CodeCraftsman-Jr/AgroWings/output/detected_sample1.jpg

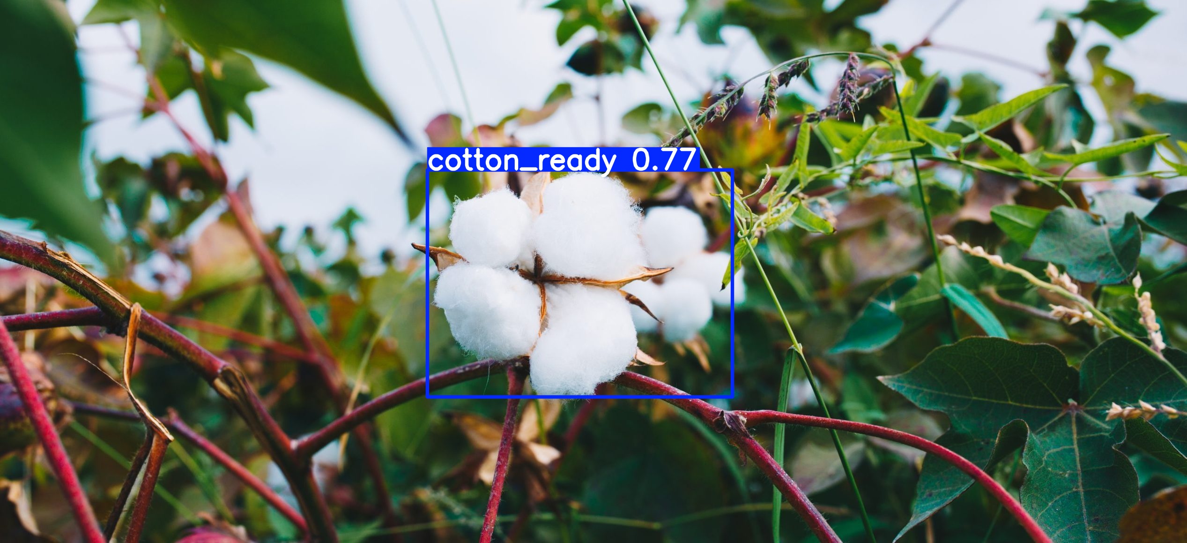
output/detected_sample1.jpg
