CodeCraftsman-Jr/AgroWings/output/detected_sample2.jpeg

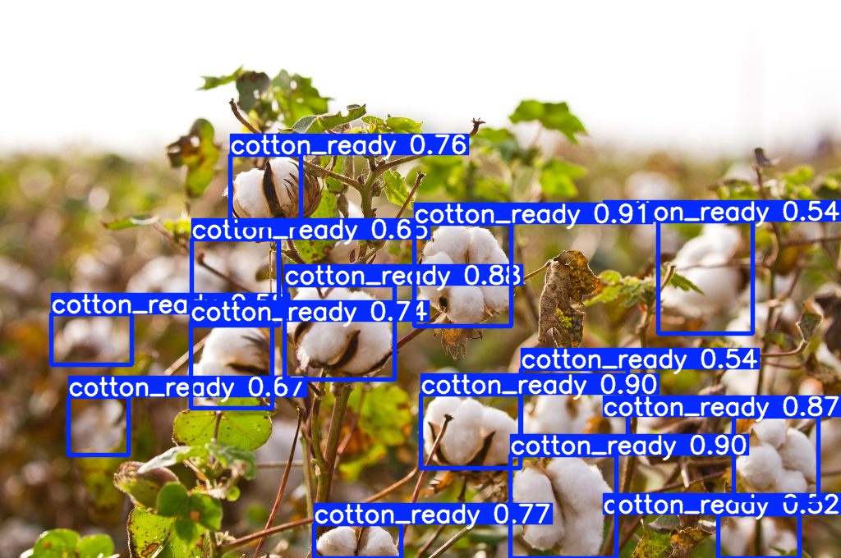
output/detected_sample2.jpeg
