CodeCraftsman-Jr/AgroWings/output/detected_sample3.jpg

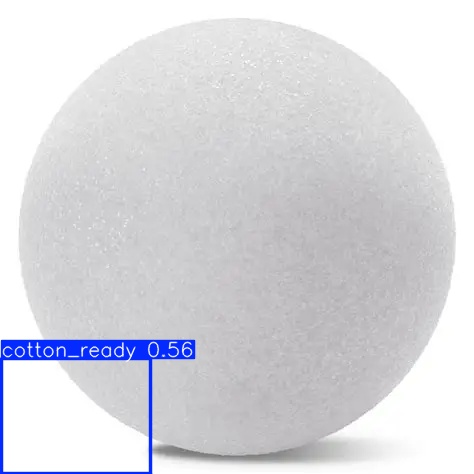
output/detected_sample3.jpg
