CodeCraftsman-Jr/AgroWings/Materials/OpenCR-Hardware-main/OpenCR-Hardware-main/mechanics/LOTR_CTCR/stl_files/Main_Frame.stl

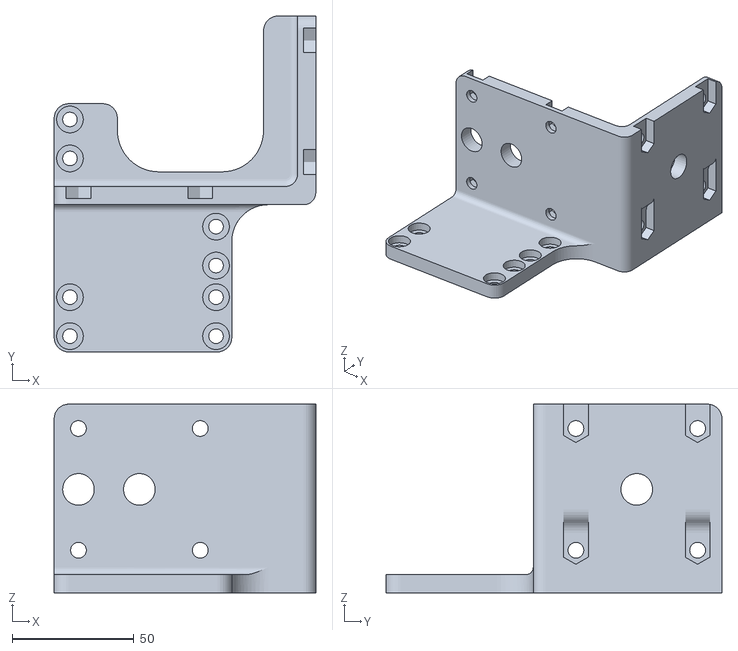
[picture p4: CAD file, 2025-11-28]
Materials/OpenCR-Hardware-main/OpenCR-Hardware-main/mechanics/LOTR_CTCR/stl_files/Main_Frame.stl
107.5 x 138.0 x 77.5
