CodeCraftsman-Jr/AgroWings/Materials/mould/FZ8OJ7DJZ2YTMDP.stl

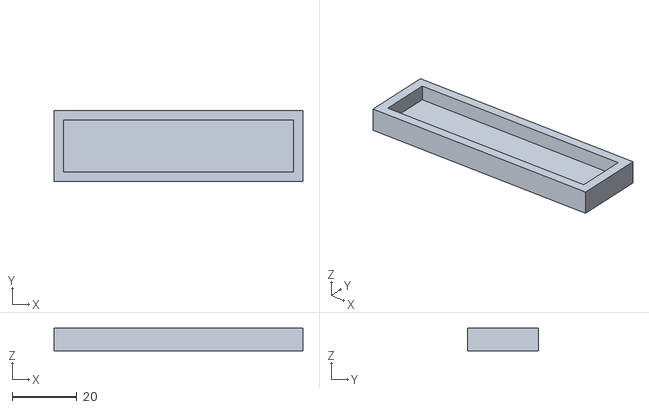
[picture p5: CAD file, 2025-11-28]
Materials/mould/FZ8OJ7DJZ2YTMDP.stl
77.0 x 22.0 x 7.00
