CodeCraftsman-Jr/AgroWings/Materials/OpenCR-Hardware-main/OpenCR-Hardware-main/mechanics/actuation_module/stl_files/ActuationUnit_EncoderCouplingSide.stl

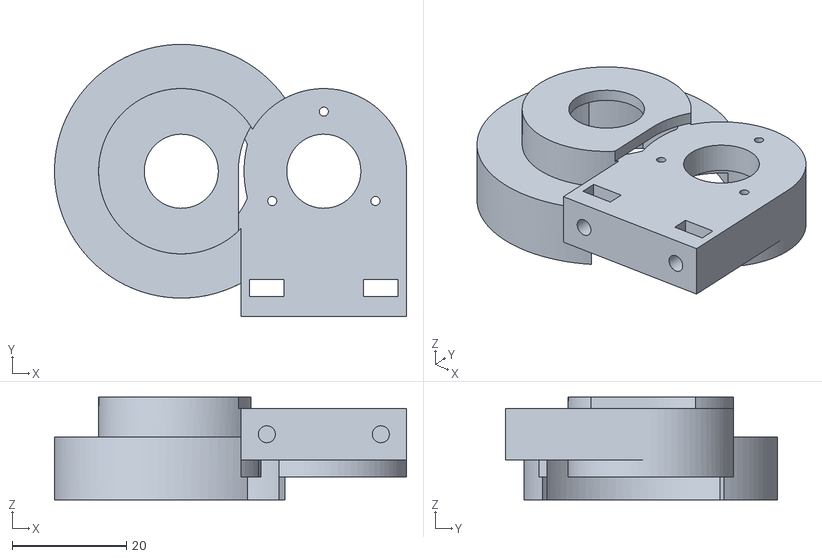
[picture p6: CAD file, 2025-11-28]
Materials/OpenCR-Hardware-main/OpenCR-Hardware-main/mechanics/actuation_module/stl_files/ActuationUnit_EncoderCouplingSide.stl
61.7 x 47.7 x 18.0
