CodeCraftsman-Jr/AgroWings/Materials/OpenCR-Hardware-main/OpenCR-Hardware-main/mechanics/auxiliary_hardware/stl_files/Repeater_vertical.stl

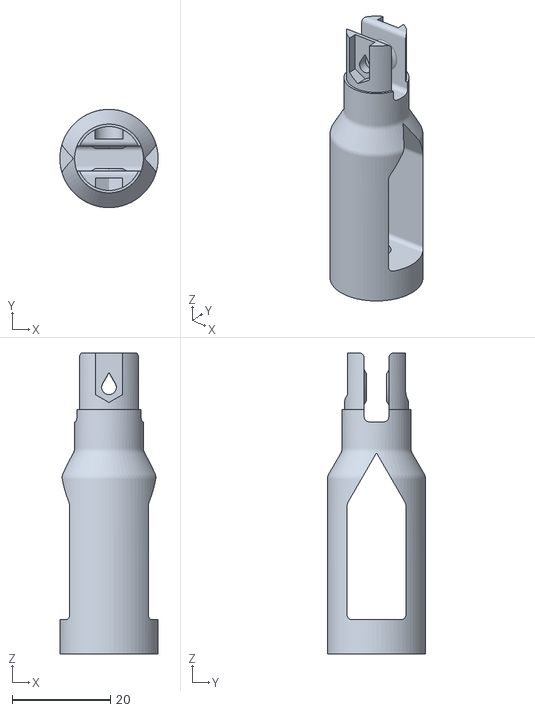
[picture p7: CAD file, 2025-11-28]
Materials/OpenCR-Hardware-main/OpenCR-Hardware-main/mechanics/auxiliary_hardware/stl_files/Repeater_vertical.stl
20.0 x 20.0 x 61.2
