CodeCraftsman-Jr/AgroWings/Materials/OpenCR-Hardware-main/OpenCR-Hardware-main/mechanics/auxiliary_tools/stl_files/FixatorDisk_OD20_13mm_Backbone_ID1.stl

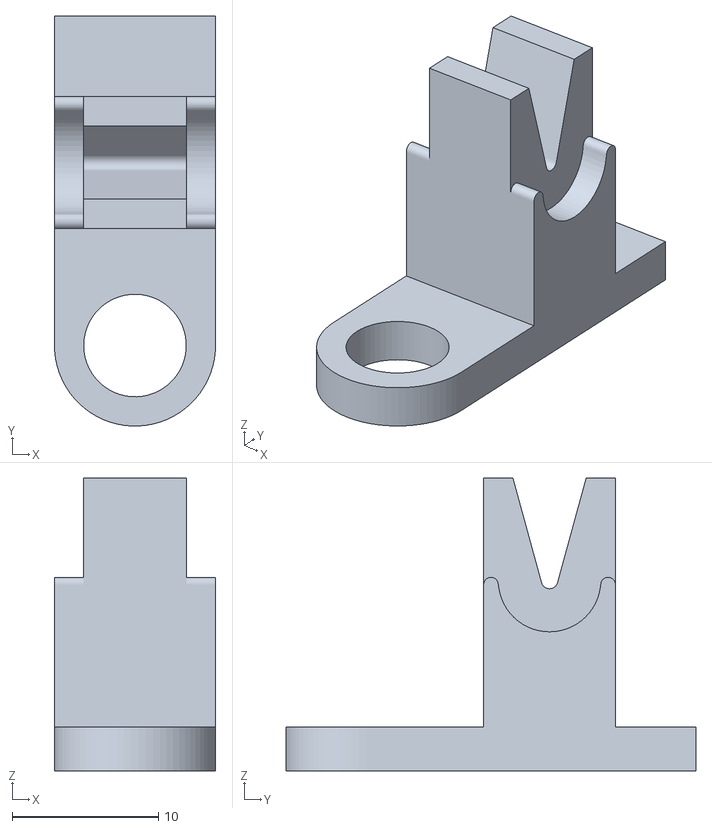
[picture p8: CAD file, 2025-11-28]
Materials/OpenCR-Hardware-main/OpenCR-Hardware-main/mechanics/auxiliary_tools/stl_files/FixatorDisk_OD20_13mm_Backbone_ID1.stl
11.0 x 28.0 x 20.0
