CodeCraftsman-Jr/AgroWings/Materials/OpenCR-Hardware-main/OpenCR-Hardware-main/mechanics/LearningKit_TDCR/stl_files/FSD_Sliced _1.stl

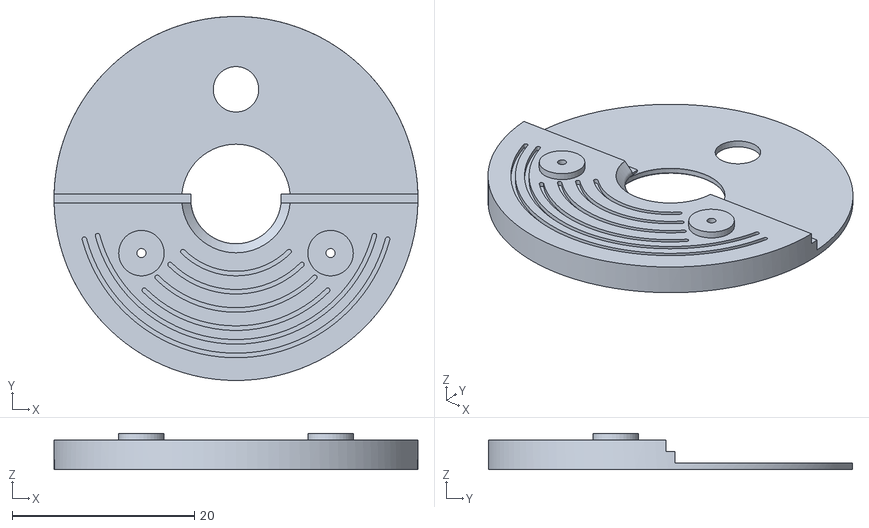
[picture p9: CAD file, 2025-11-28]
Materials/OpenCR-Hardware-main/OpenCR-Hardware-main/mechanics/LearningKit_TDCR/stl_files/FSD_Sliced _1.stl
40.0 x 40.0 x 4.00
