CodeCraftsman-Jr/AgroWings/Materials/OpenCR-Hardware-main/OpenCR-Hardware-main/mechanics/LOTR_CTCR/stl_files/Tube_coppling_0mm49.stl

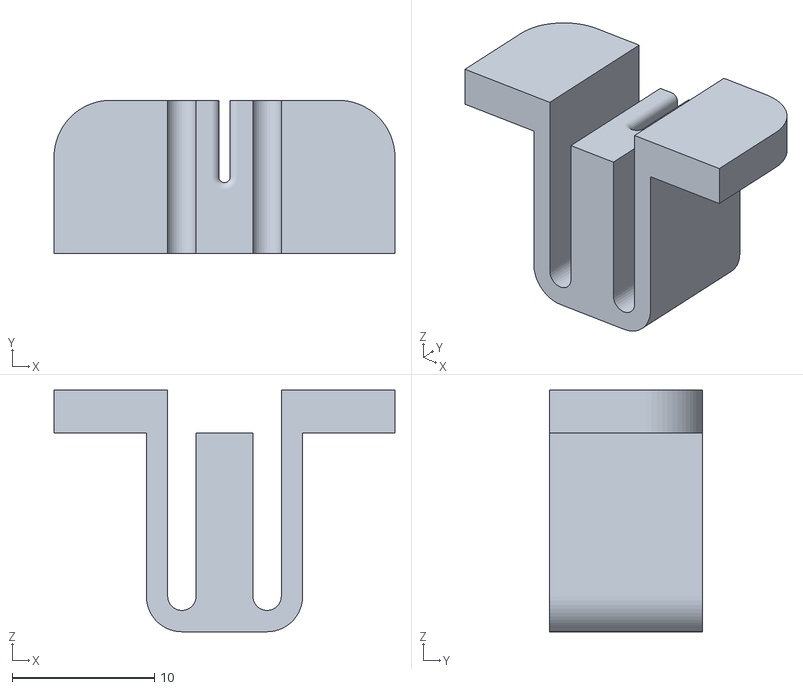
[picture p10: CAD file, 2025-11-28]
Materials/OpenCR-Hardware-main/OpenCR-Hardware-main/mechanics/LOTR_CTCR/stl_files/Tube_coppling_0mm49.stl
24.0 x 10.8 x 17.0
