CodeCraftsman-Jr/AgroWings/Materials/OpenCR-Hardware-main/OpenCR-Hardware-main/mechanics/LOTR_TDCR-planar/stl_files/EE_glider_small.stl

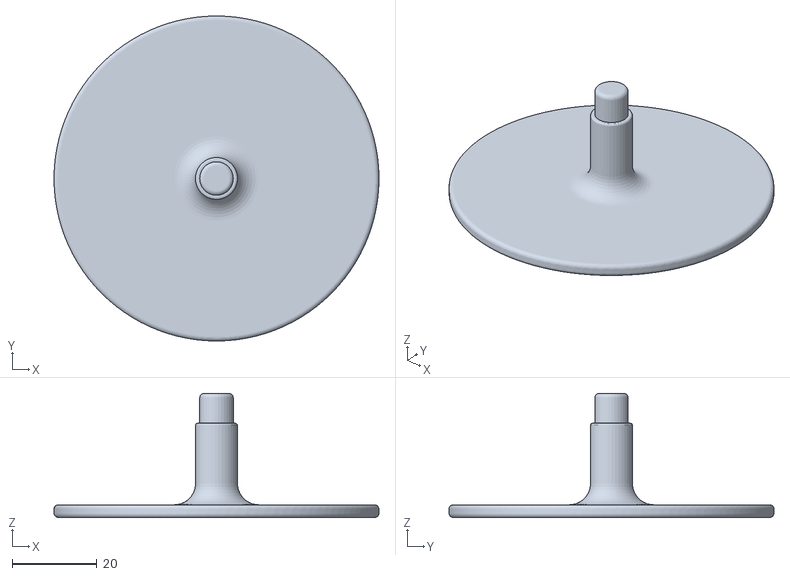
[picture p11: CAD file, 2025-11-28]
Materials/OpenCR-Hardware-main/OpenCR-Hardware-main/mechanics/LOTR_TDCR-planar/stl_files/EE_glider_small.stl
76.5 x 76.5 x 29.2
