CodeCraftsman-Jr/AgroWings/Materials/OpenCR-Hardware-main/OpenCR-Hardware-main/mechanics/LOTR_TDCR-spatial/stl_files/FSD_20mm_bearing_withoutDent.stl

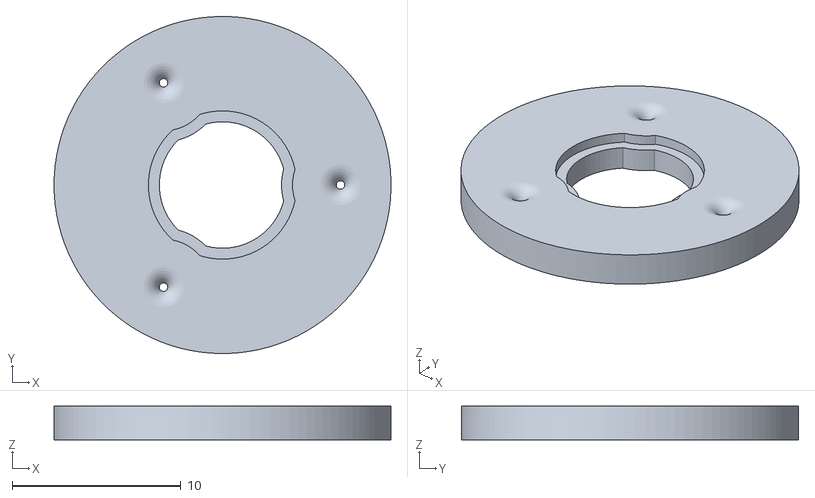
[picture p12: CAD file, 2025-11-28]
Materials/OpenCR-Hardware-main/OpenCR-Hardware-main/mechanics/LOTR_TDCR-spatial/stl_files/FSD_20mm_bearing_withoutDent.stl
20.0 x 20.0 x 2.00
