CodeCraftsman-Jr/AgroWings/Materials/OpenCR-Hardware-main/OpenCR-Hardware-main/mechanics/LOTR_toy_examples/First_Toy_Example/stl_files/Stand_for_weights.stl

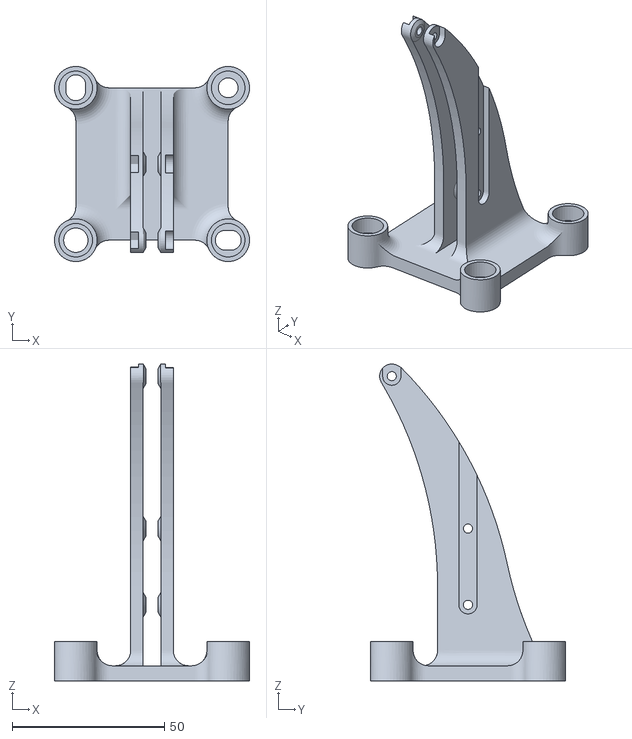
[picture p13: CAD file, 2025-11-28]
Materials/OpenCR-Hardware-main/OpenCR-Hardware-main/mechanics/LOTR_toy_examples/First_Toy_Example/stl_files/Stand_for_weights.stl
64.0 x 64.0 x 104.0
