CodeCraftsman-Jr/AgroWings/Materials/OpenCR-Hardware-main/OpenCR-Hardware-main/mechanics/LOTR_toy_examples/Second_Toy_Example/stl_files/Spacer_Disk.stl

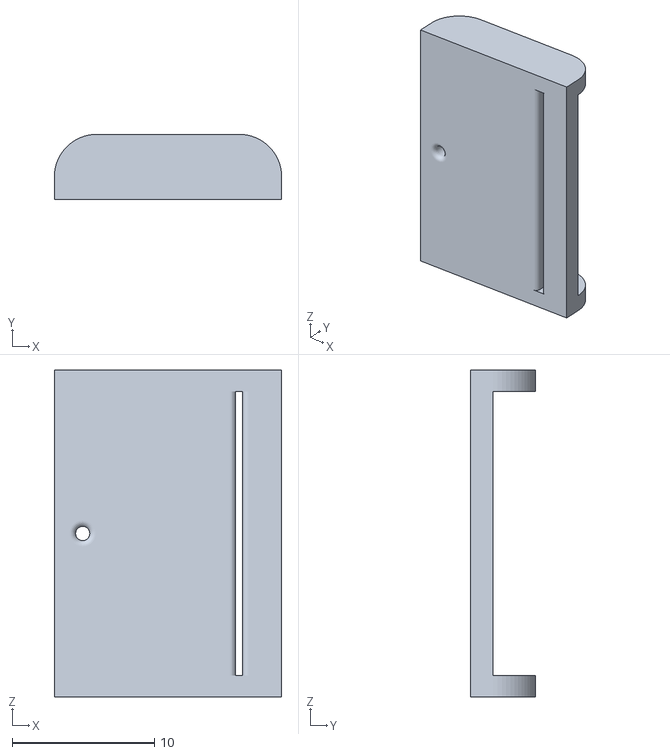
[picture p14: CAD file, 2025-11-28]
Materials/OpenCR-Hardware-main/OpenCR-Hardware-main/mechanics/LOTR_toy_examples/Second_Toy_Example/stl_files/Spacer_Disk.stl
16.0 x 4.60 x 23.0
