CodeCraftsman-Jr/AgroWings/Materials/mould/F9YAXHUJZ2YXE2W.stl

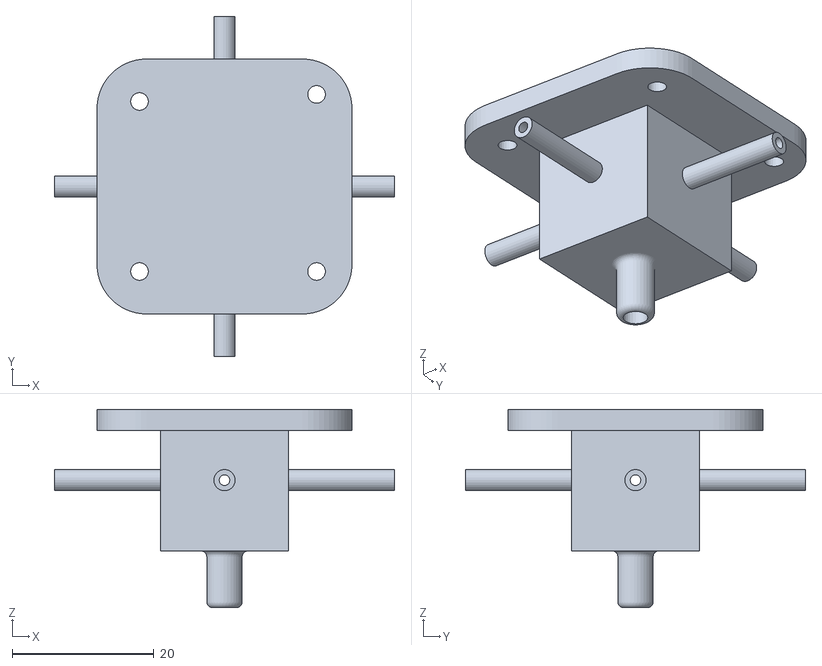
[picture p15: CAD file, 2025-11-28]
Materials/mould/F9YAXHUJZ2YXE2W.stl
48.0 x 48.0 x 28.0
