CodeCraftsman-Jr/AgroWings/Materials/OpenCR-Hardware-main/OpenCR-Hardware-main/mechanics/actuation_module/stl_files/ActuationUnit_MotorSide_Cube.stl

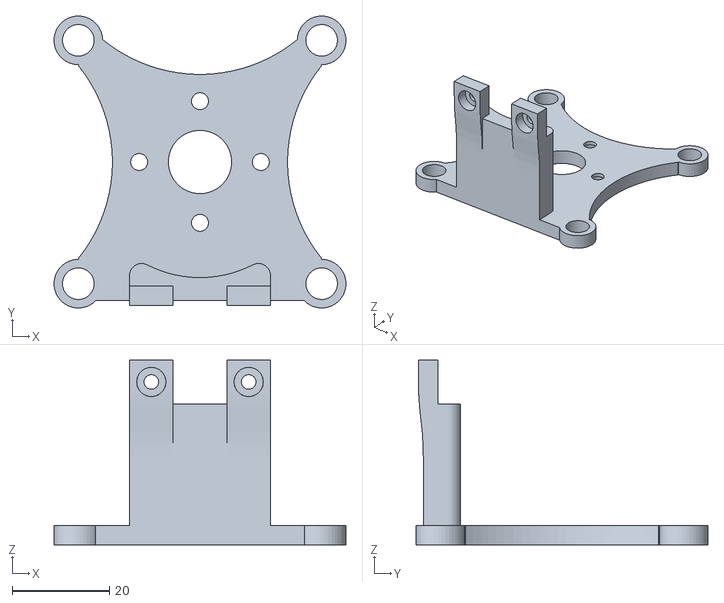
[picture p16: CAD file, 2025-11-28]
Materials/OpenCR-Hardware-main/OpenCR-Hardware-main/mechanics/actuation_module/stl_files/ActuationUnit_MotorSide_Cube.stl
60.0 x 60.0 x 38.0
