CodeCraftsman-Jr/AgroWings/Materials/OpenCR-Hardware-main/OpenCR-Hardware-main/mechanics/auxiliary_tools/stl_files/BearingInsertion.stl

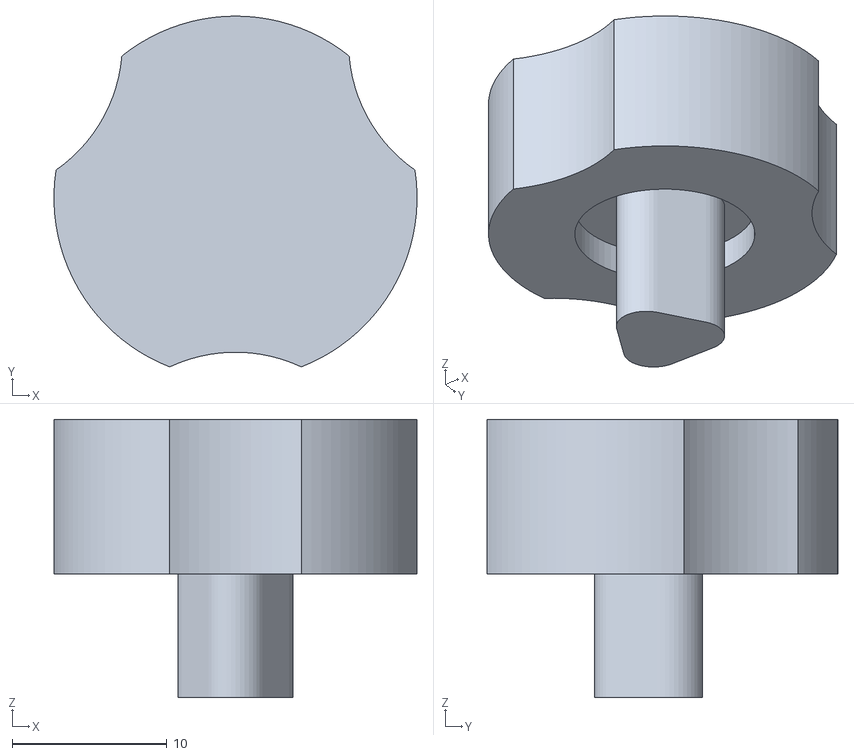
[picture p18: CAD file, 2025-11-28]
Materials/OpenCR-Hardware-main/OpenCR-Hardware-main/mechanics/auxiliary_tools/stl_files/BearingInsertion.stl
23.5 x 22.7 x 18.0
