CodeCraftsman-Jr/AgroWings/Materials/OpenCR-Hardware-main/OpenCR-Hardware-main/mechanics/LOTR_CTCR/stl_files/Tube_Cap.stl

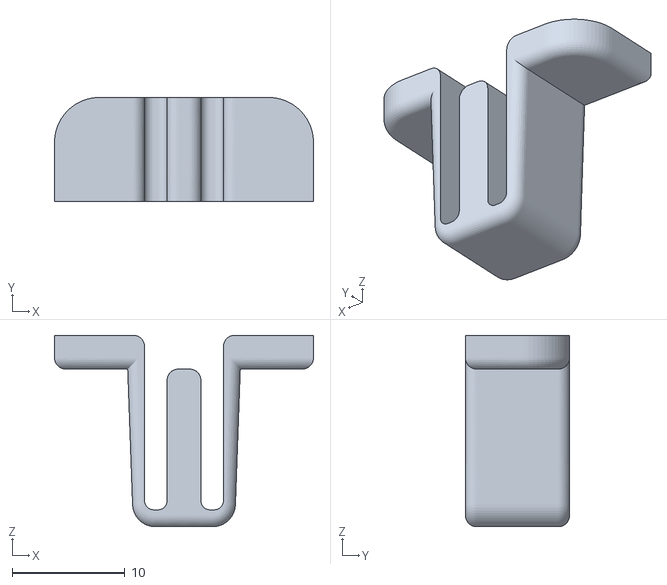
[picture p19: CAD file, 2025-11-28]
Materials/OpenCR-Hardware-main/OpenCR-Hardware-main/mechanics/LOTR_CTCR/stl_files/Tube_Cap.stl
23.0 x 9.25 x 17.0
