CodeCraftsman-Jr/AgroWings/Materials/OpenCR-Hardware-main/OpenCR-Hardware-main/mechanics/LOTR_TDCR-planar/stl_files/rail2table_connector_left.stl

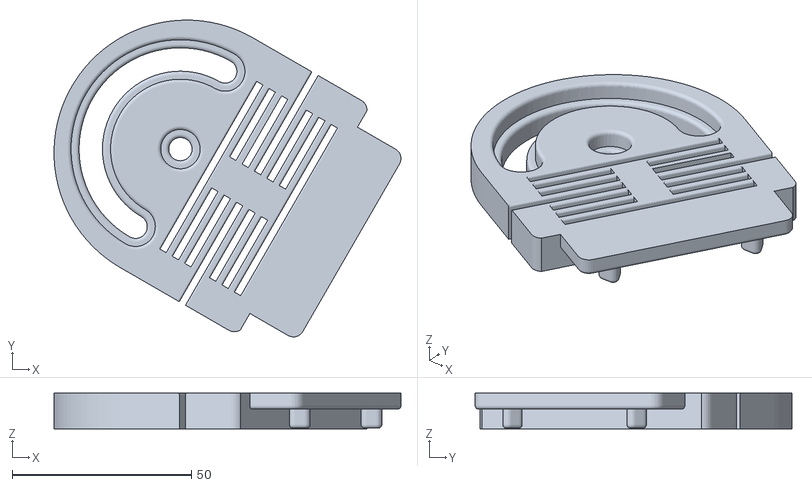
[picture p20: CAD file, 2025-11-28]
Materials/OpenCR-Hardware-main/OpenCR-Hardware-main/mechanics/LOTR_TDCR-planar/stl_files/rail2table_connector_left.stl
96.8 x 88.4 x 10.0
