CodeCraftsman-Jr/AgroWings/Materials/OpenCR-Hardware-main/OpenCR-Hardware-main/mechanics/LOTR_TDCR-spatial/stl_files/BasePlatform.stl

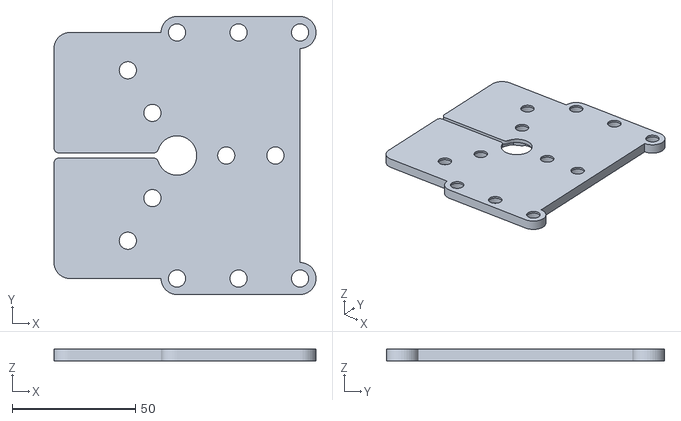
[picture p21: CAD file, 2025-11-28]
Materials/OpenCR-Hardware-main/OpenCR-Hardware-main/mechanics/LOTR_TDCR-spatial/stl_files/BasePlatform.stl
106.5 x 113.0 x 5.00
