CodeCraftsman-Jr/AgroWings/Materials/OpenCR-Hardware-main/OpenCR-Hardware-main/mechanics/LOTR_toy_examples/Second_Toy_Example/stl_files/base_top.stl

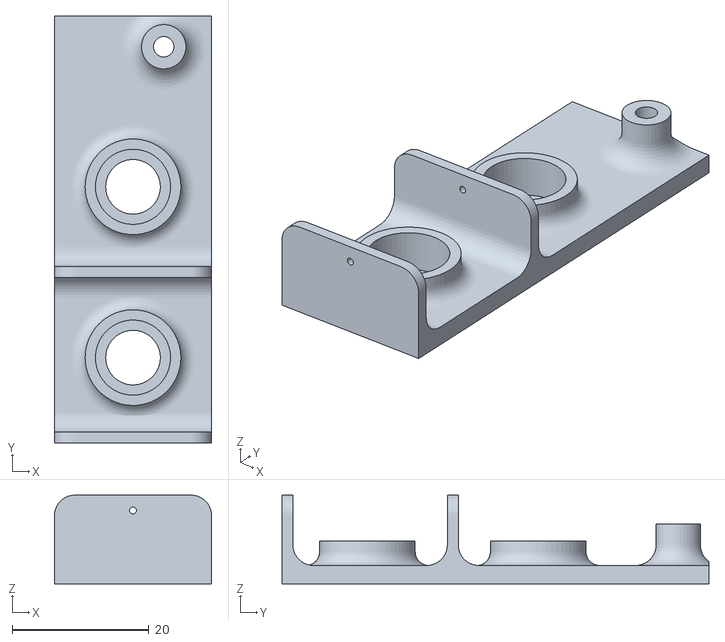
[picture p22: CAD file, 2025-11-28]
Materials/OpenCR-Hardware-main/OpenCR-Hardware-main/mechanics/LOTR_toy_examples/Second_Toy_Example/stl_files/base_top.stl
23.0 x 62.5 x 13.0
