CodeCraftsman-Jr/AgroWings/Materials/mould/FI3IV8LJZ2YTMDT.stl

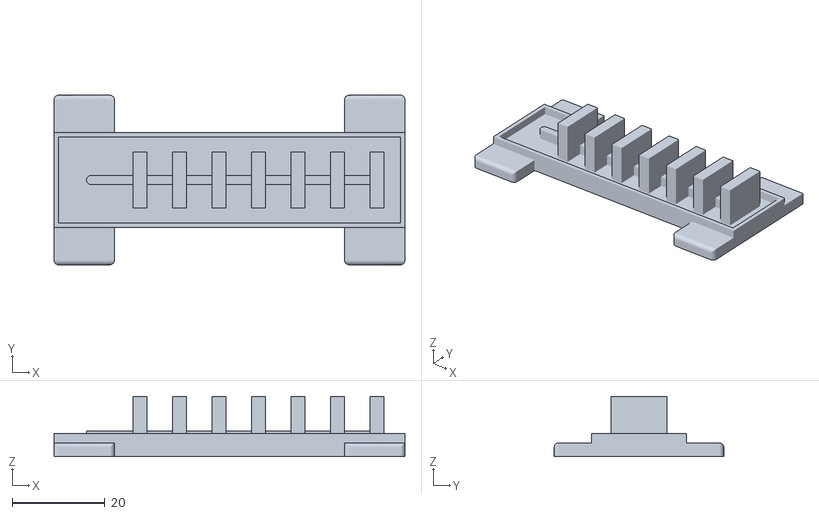
[picture p23: CAD file, 2025-11-28]
Materials/mould/FI3IV8LJZ2YTMDT.stl
75.5 x 36.5 x 13.0
