CodeCraftsman-Jr/AgroWings/Materials/OpenCR-Hardware-main/OpenCR-Hardware-main/mechanics/actuation_module/stl_files/Shaft_GearCoupling.stl

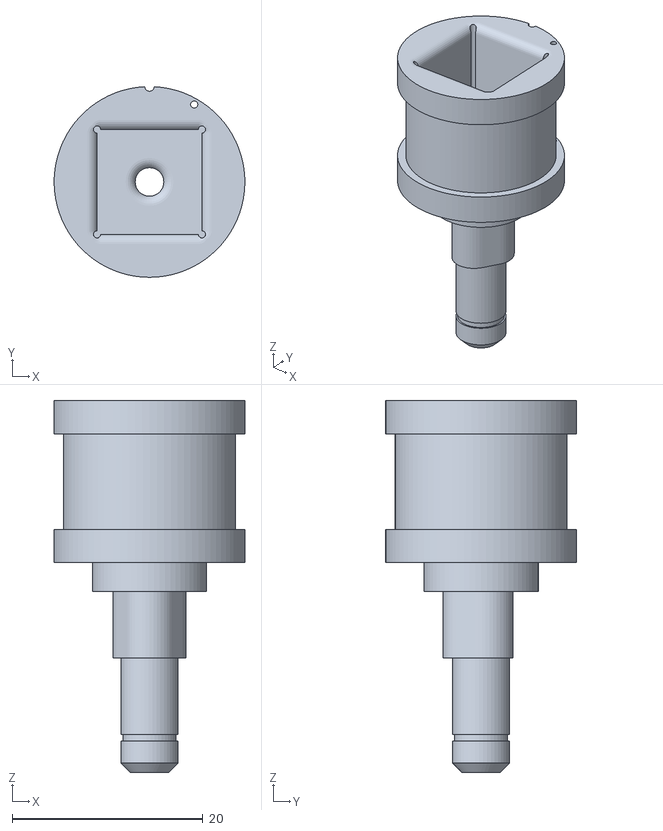
[picture p24: CAD file, 2025-11-28]
Materials/OpenCR-Hardware-main/OpenCR-Hardware-main/mechanics/actuation_module/stl_files/Shaft_GearCoupling.stl
20.0 x 20.0 x 39.0
