CodeCraftsman-Jr/AgroWings/Materials/OpenCR-Hardware-main/OpenCR-Hardware-main/mechanics/auxiliary_hardware/stl_files/Repeater_horizontal.stl

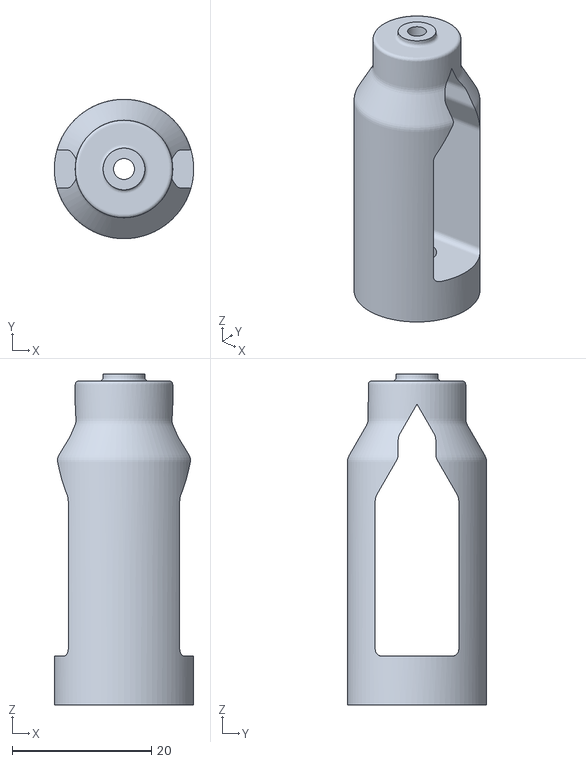
[picture p25: CAD file, 2025-11-28]
Materials/OpenCR-Hardware-main/OpenCR-Hardware-main/mechanics/auxiliary_hardware/stl_files/Repeater_horizontal.stl
20.0 x 20.0 x 47.5
