CodeCraftsman-Jr/AgroWings/Materials/OpenCR-Hardware-main/OpenCR-Hardware-main/mechanics/LearningKit_TDCR/stl_files/ShaftGearCoupling_for_Tendon.stl

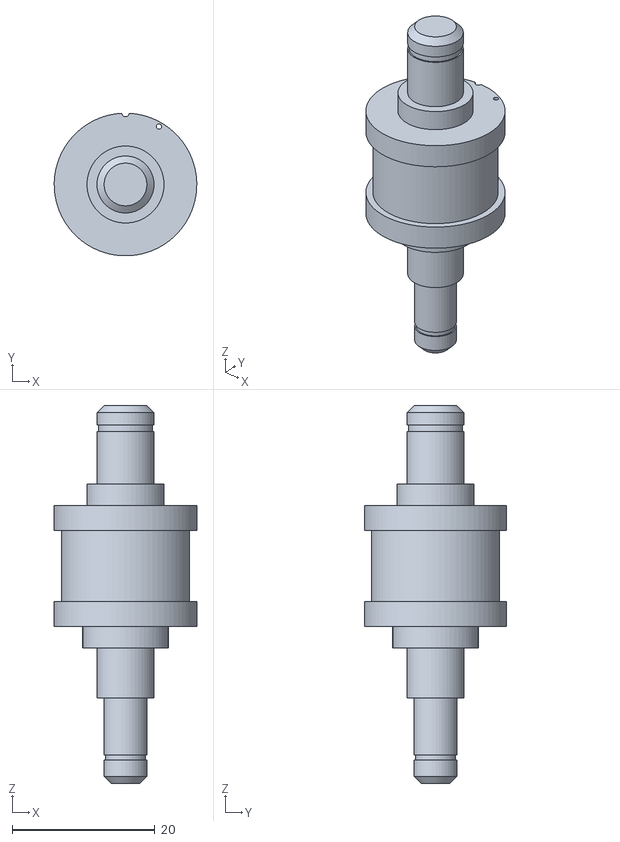
[picture p26: CAD file, 2025-11-28]
Materials/OpenCR-Hardware-main/OpenCR-Hardware-main/mechanics/LearningKit_TDCR/stl_files/ShaftGearCoupling_for_Tendon.stl
20.0 x 20.0 x 53.0
