CodeCraftsman-Jr/AgroWings/Materials/OpenCR-Hardware-main/OpenCR-Hardware-main/mechanics/LOTR_CTCR/stl_files/Front_Frame.stl

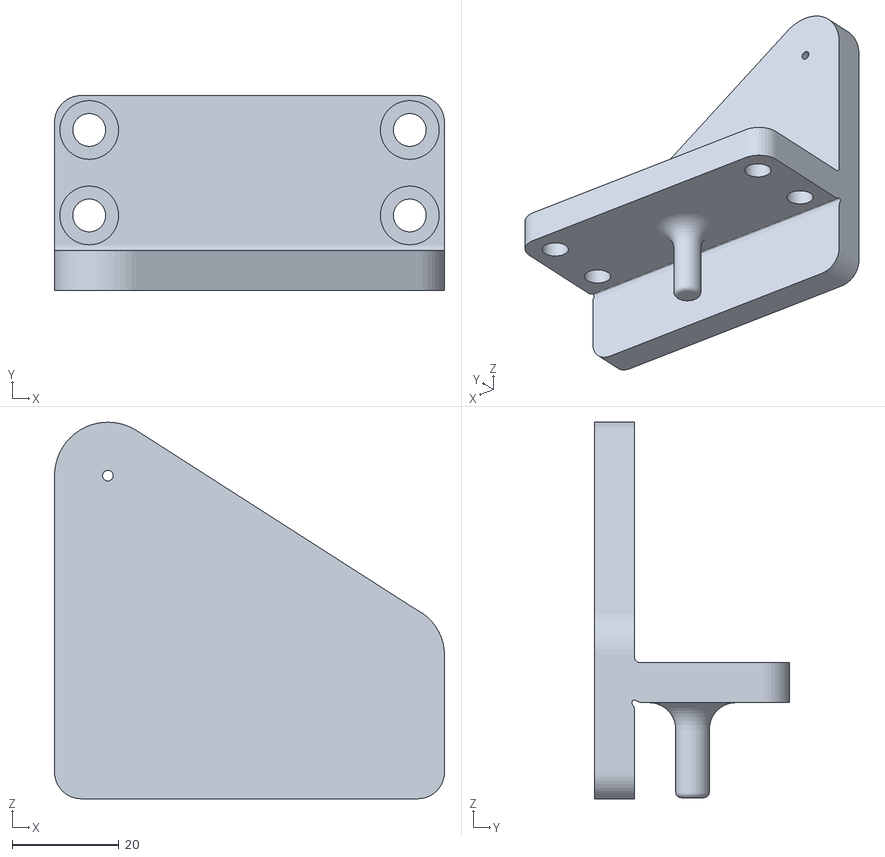
[picture p27: CAD file, 2025-11-28]
Materials/OpenCR-Hardware-main/OpenCR-Hardware-main/mechanics/LOTR_CTCR/stl_files/Front_Frame.stl
73.0 x 36.5 x 70.5
