CodeCraftsman-Jr/AgroWings/Materials/OpenCR-Hardware-main/OpenCR-Hardware-main/mechanics/LOTR_TDCR-planar/stl_files/spacer_disk.stl

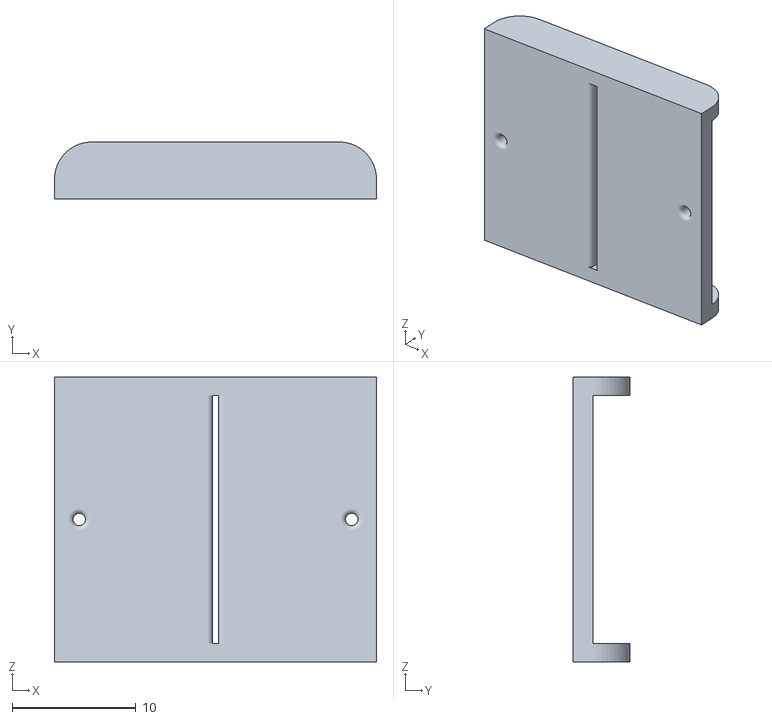
[picture p28: CAD file, 2025-11-28]
Materials/OpenCR-Hardware-main/OpenCR-Hardware-main/mechanics/LOTR_TDCR-planar/stl_files/spacer_disk.stl
26.0 x 4.60 x 23.0
