CodeCraftsman-Jr/AgroWings/Materials/OpenCR-Hardware-main/OpenCR-Hardware-main/mechanics/LOTR_toy_examples/Second_Toy_Example/stl_files/Spacer_DiskEnd.stl

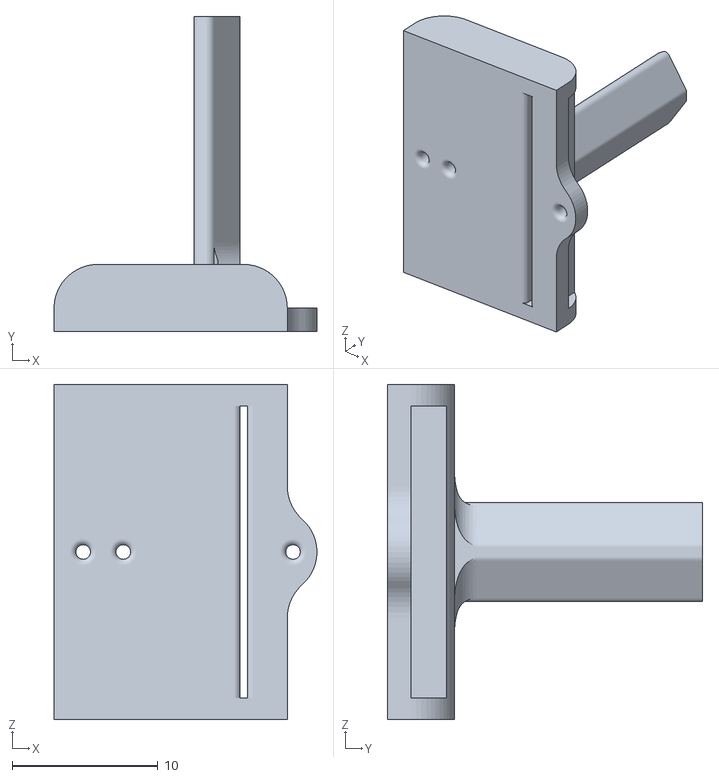
[picture p29: CAD file, 2025-11-28]
Materials/OpenCR-Hardware-main/OpenCR-Hardware-main/mechanics/LOTR_toy_examples/Second_Toy_Example/stl_files/Spacer_DiskEnd.stl
18.0 x 21.6 x 23.0
