CodeCraftsman-Jr/AgroWings/Materials/mould/F92EQXRJZ2YTMDV.stl

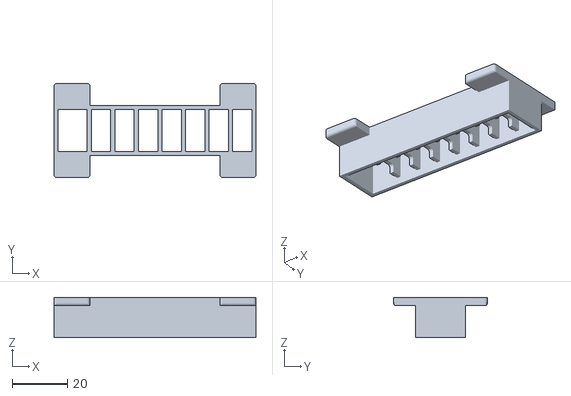
[picture p30: CAD file, 2025-11-28]
Materials/mould/F92EQXRJZ2YTMDV.stl
73.0 x 34.0 x 14.5
