CodeCraftsman-Jr/AgroWings/Materials/OpenCR-Hardware-main/OpenCR-Hardware-main/mechanics/actuation_module/stl_files/Shaft_MotorEncoder.stl

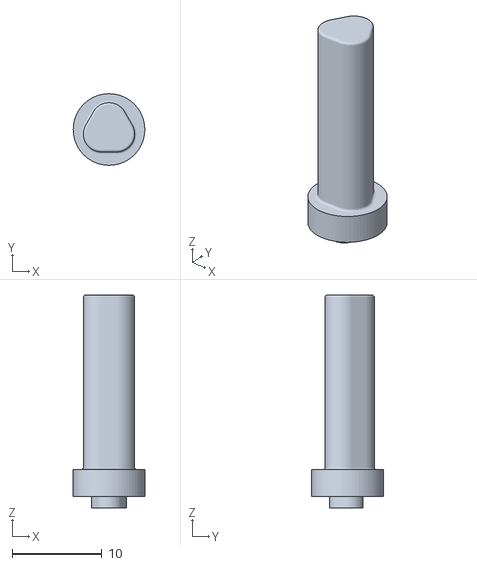
[picture p31: CAD file, 2025-11-28]
Materials/OpenCR-Hardware-main/OpenCR-Hardware-main/mechanics/actuation_module/stl_files/Shaft_MotorEncoder.stl
8.00 x 8.00 x 23.8
