CodeCraftsman-Jr/AgroWings/Materials/OpenCR-Hardware-main/OpenCR-Hardware-main/mechanics/auxiliary_hardware/stl_files/EmergencyStop_base.stl

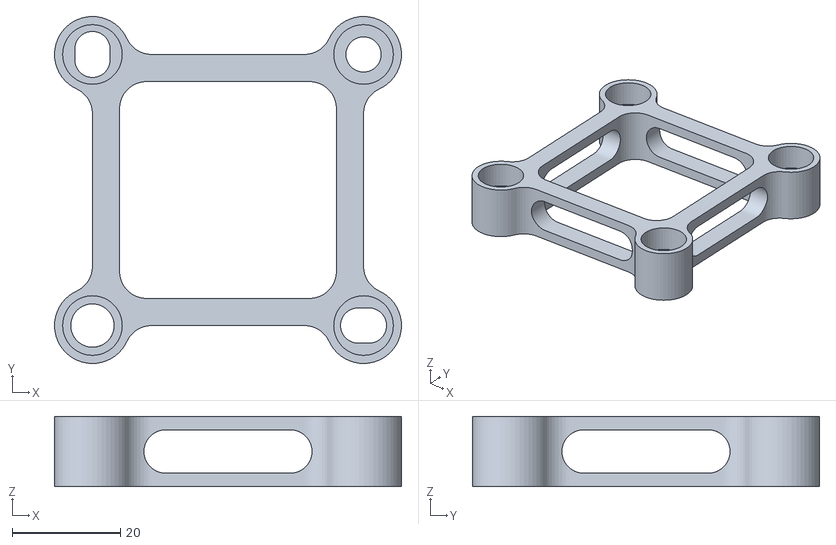
[picture p32: CAD file, 2025-11-28]
Materials/OpenCR-Hardware-main/OpenCR-Hardware-main/mechanics/auxiliary_hardware/stl_files/EmergencyStop_base.stl
64.0 x 64.0 x 13.0
