CodeCraftsman-Jr/AgroWings/Materials/OpenCR-Hardware-main/OpenCR-Hardware-main/mechanics/LearningKit_TDCR/stl_files/Base_Casing.stl

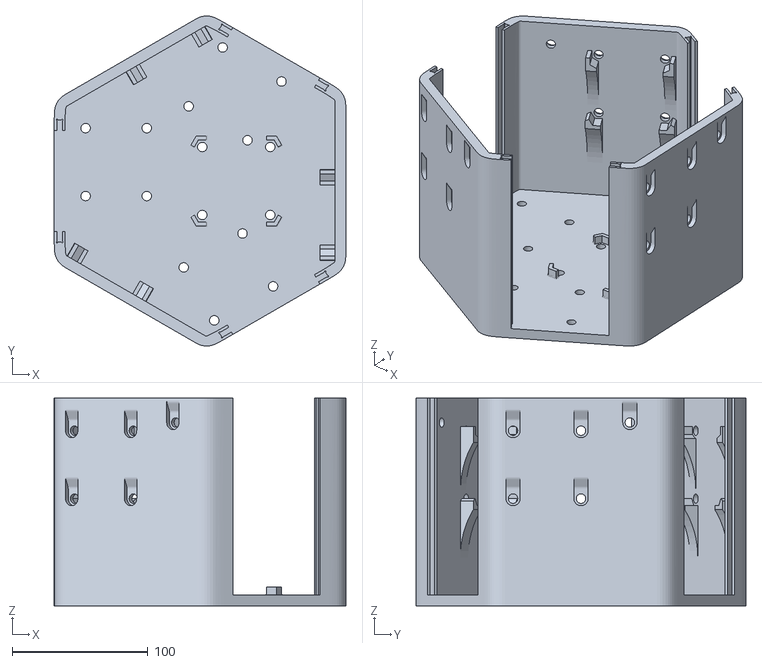
[picture p33: CAD file, 2025-11-28]
Materials/OpenCR-Hardware-main/OpenCR-Hardware-main/mechanics/LearningKit_TDCR/stl_files/Base_Casing.stl
214.6 x 242.8 x 153.0
