CodeCraftsman-Jr/AgroWings/Materials/OpenCR-Hardware-main/OpenCR-Hardware-main/mechanics/LOTR_CTCR/stl_files/Cap_Gear_8mm.stl

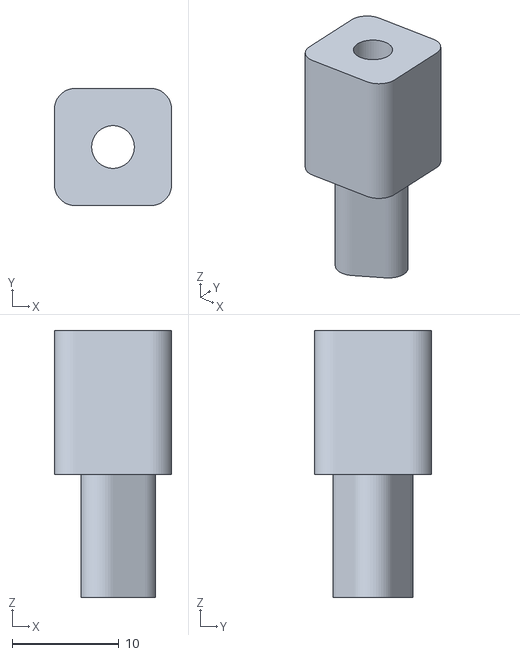
[picture p34: CAD file, 2025-11-28]
Materials/OpenCR-Hardware-main/OpenCR-Hardware-main/mechanics/LOTR_CTCR/stl_files/Cap_Gear_8mm.stl
11.0 x 11.0 x 25.0
