CodeCraftsman-Jr/AgroWings/Materials/OpenCR-Hardware-main/OpenCR-Hardware-main/mechanics/LOTR_TDCR-planar/stl_files/frame_base_plate.stl

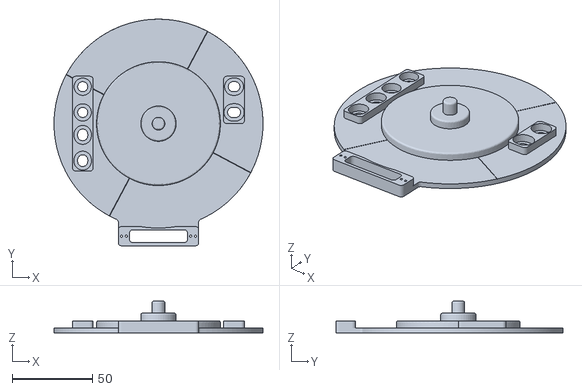
[picture p35: CAD file, 2025-11-28]
Materials/OpenCR-Hardware-main/OpenCR-Hardware-main/mechanics/LOTR_TDCR-planar/stl_files/frame_base_plate.stl
130.0 x 141.0 x 19.8
