CodeCraftsman-Jr/AgroWings/Materials/OpenCR-Hardware-main/OpenCR-Hardware-main/mechanics/LOTR_TDCR-spatial/stl_files/BasePlatform_PulleyShaft.stl

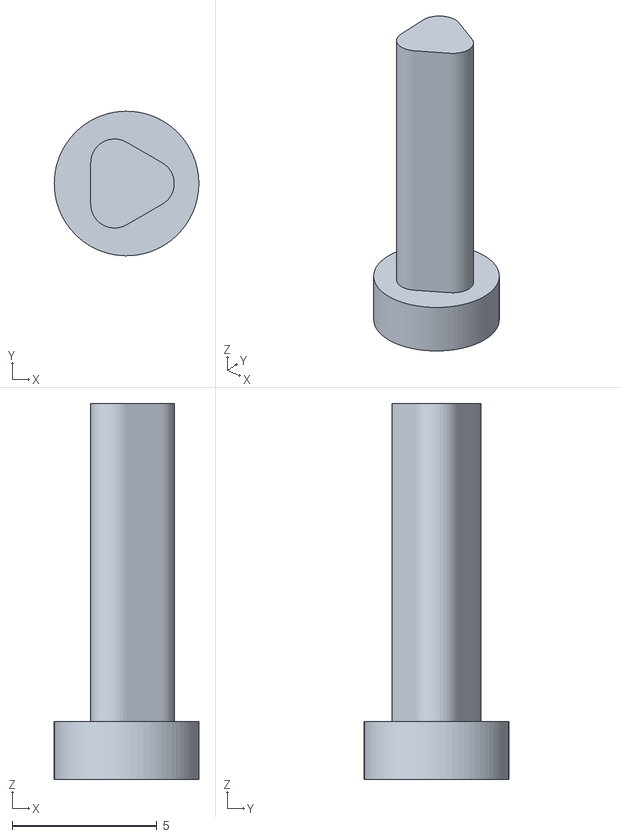
[picture p36: CAD file, 2025-11-28]
Materials/OpenCR-Hardware-main/OpenCR-Hardware-main/mechanics/LOTR_TDCR-spatial/stl_files/BasePlatform_PulleyShaft.stl
5.00 x 5.00 x 13.0
