CodeCraftsman-Jr/AgroWings/Materials/OpenCR-Hardware-main/OpenCR-Hardware-main/mechanics/LOTR_toy_examples/Second_Toy_Example/stl_files/Base_vertical.stl

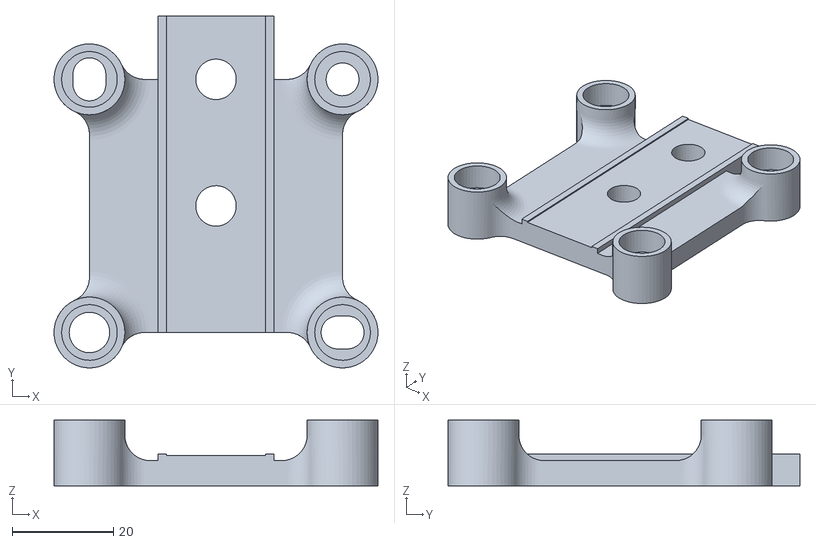
[picture p37: CAD file, 2025-11-28]
Materials/OpenCR-Hardware-main/OpenCR-Hardware-main/mechanics/LOTR_toy_examples/Second_Toy_Example/stl_files/Base_vertical.stl
64.0 x 69.5 x 13.0
