CodeCraftsman-Jr/AgroWings/Materials/OpenCR-Hardware-main/OpenCR-Hardware-main/mechanics/auxiliary_hardware/stl_files/EmergencyStop_top.stl

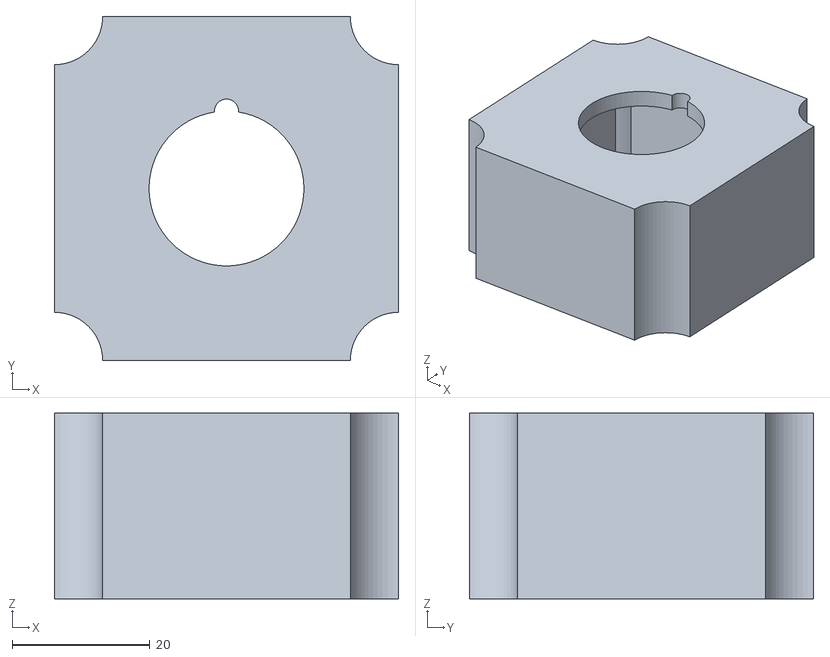
[picture p38: CAD file, 2025-11-28]
Materials/OpenCR-Hardware-main/OpenCR-Hardware-main/mechanics/auxiliary_hardware/stl_files/EmergencyStop_top.stl
50.0 x 50.0 x 27.0
