CodeCraftsman-Jr/AgroWings/Materials/OpenCR-Hardware-main/OpenCR-Hardware-main/mechanics/LearningKit_TDCR/stl_files/ShaftMotorEncoder_for_Tendon.stl

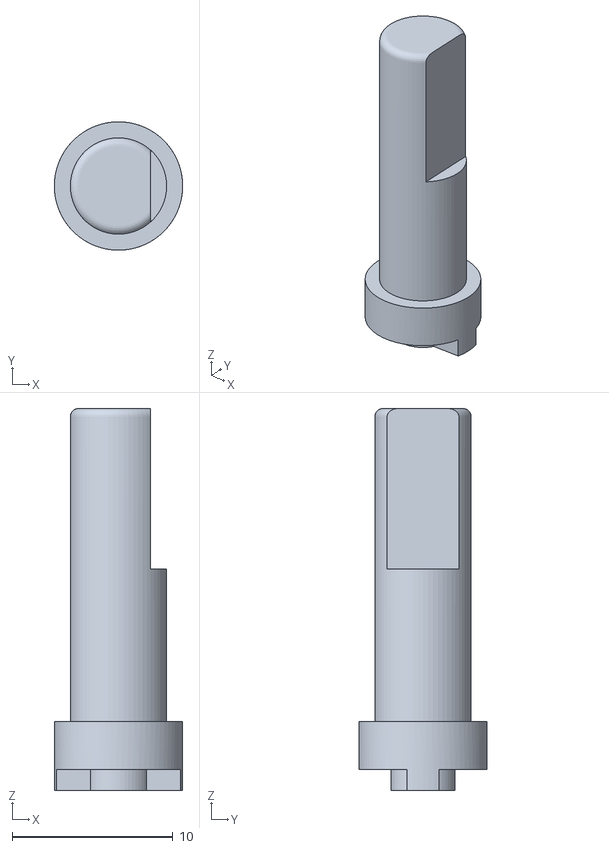
[picture p39: CAD file, 2025-11-28]
Materials/OpenCR-Hardware-main/OpenCR-Hardware-main/mechanics/LearningKit_TDCR/stl_files/ShaftMotorEncoder_for_Tendon.stl
8.00 x 8.00 x 23.8
