CodeCraftsman-Jr/AgroWings/Materials/OpenCR-Hardware-main/OpenCR-Hardware-main/mechanics/LOTR_TDCR-planar/stl_files/EE_top.stl

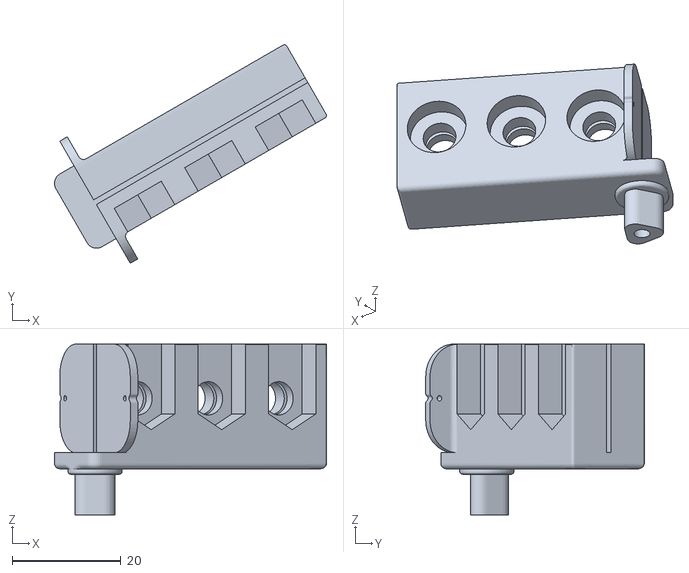
[picture p40: CAD file, 2025-11-28]
Materials/OpenCR-Hardware-main/OpenCR-Hardware-main/mechanics/LOTR_TDCR-planar/stl_files/EE_top.stl
50.1 x 40.3 x 31.5
