CodeCraftsman-Jr/AgroWings/Materials/OpenCR-Hardware-main/OpenCR-Hardware-main/mechanics/LOTR_TDCR-spatial/stl_files/BasePlatform_PullyHolder.stl

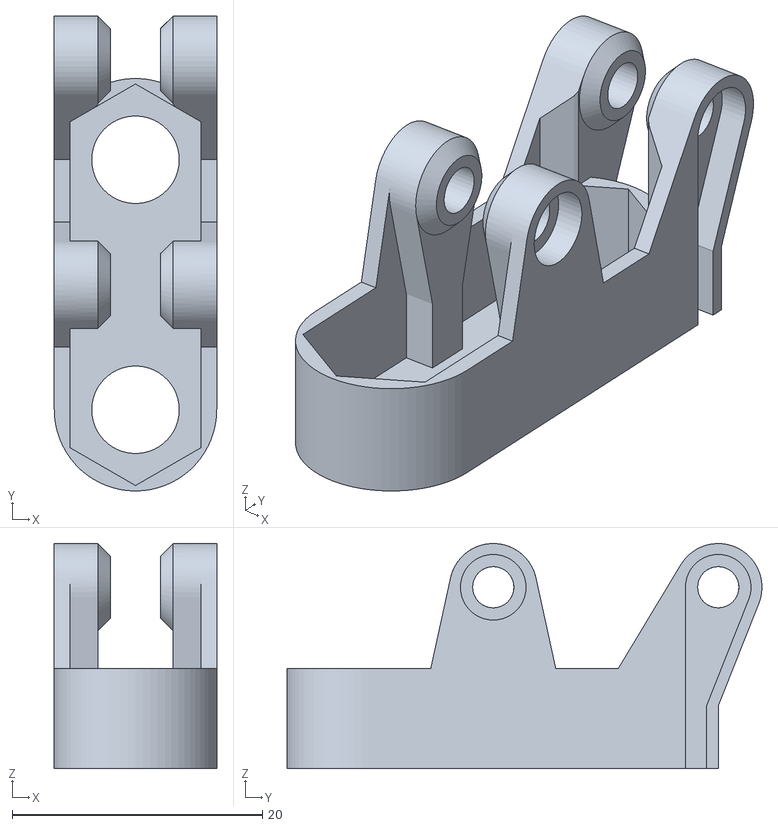
[picture p41: CAD file, 2025-11-28]
Materials/OpenCR-Hardware-main/OpenCR-Hardware-main/mechanics/LOTR_TDCR-spatial/stl_files/BasePlatform_PullyHolder.stl
13.0 x 38.0 x 18.0
