CodeCraftsman-Jr/AgroWings/Materials/OpenCR-Hardware-main/OpenCR-Hardware-main/mechanics/LearningKit_TDCR/stl_files/Hexagon_wall.stl

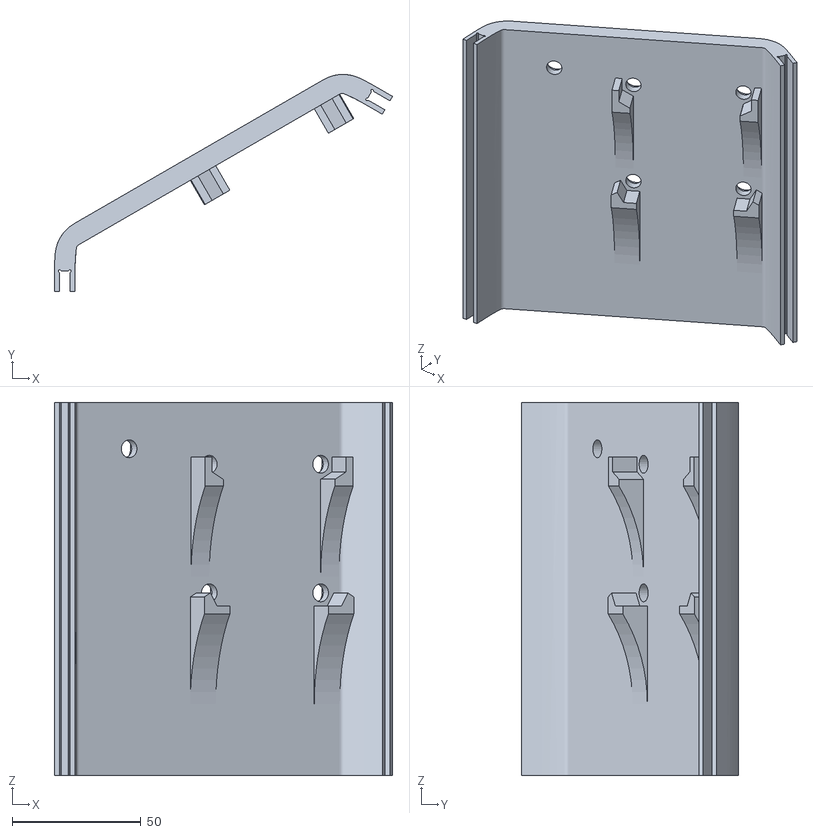
[picture p43: CAD file, 2025-11-28]
Materials/OpenCR-Hardware-main/OpenCR-Hardware-main/mechanics/LearningKit_TDCR/stl_files/Hexagon_wall.stl
131.4 x 84.4 x 145.0
