CodeCraftsman-Jr/AgroWings/Materials/OpenCR-Hardware-main/OpenCR-Hardware-main/mechanics/LOTR_TDCR-spatial/stl_files/FSDzero_20mm.stl

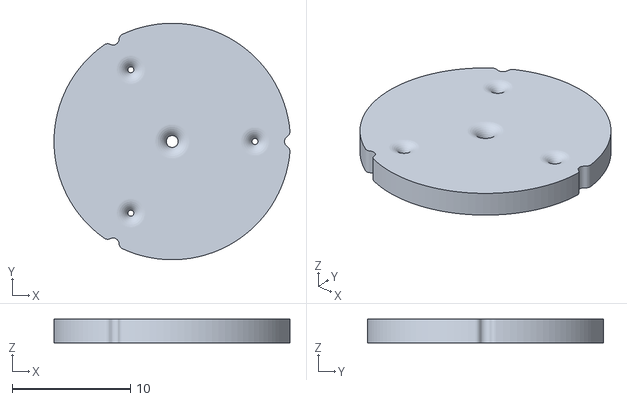
[picture p46: CAD file, 2025-11-28]
Materials/OpenCR-Hardware-main/OpenCR-Hardware-main/mechanics/LOTR_TDCR-spatial/stl_files/FSDzero_20mm.stl
20.0 x 20.0 x 2.00
