CodeCraftsman-Jr/AgroWings/Materials/OpenCR-Hardware-main/OpenCR-Hardware-main/mechanics/LearningKit_TDCR/stl_files/Casing_for_Tendon_Actuation_Module.stl

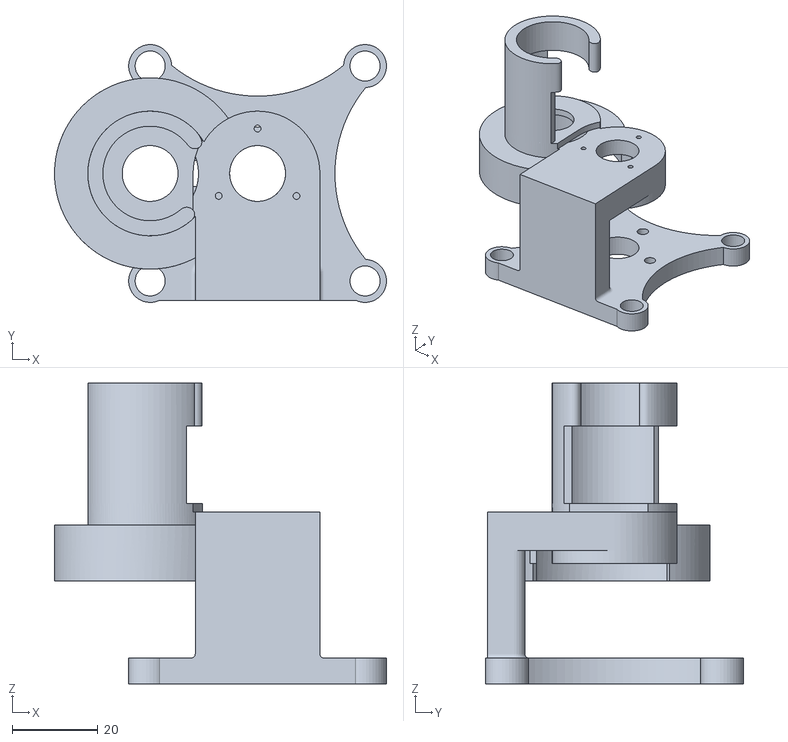
[picture p57: CAD file, 2025-11-28]
Materials/OpenCR-Hardware-main/OpenCR-Hardware-main/mechanics/LearningKit_TDCR/stl_files/Casing_for_Tendon_Actuation_Module.stl
77.2 x 60.0 x 70.0
