CodeCraftsman-Jr/AgroWings/Materials/OpenCR-Hardware-main/OpenCR-Hardware-main/mechanics/actuation_module/Instruction Manual_Modular Actuation Unit.pdf

# Modular Actuation Unit

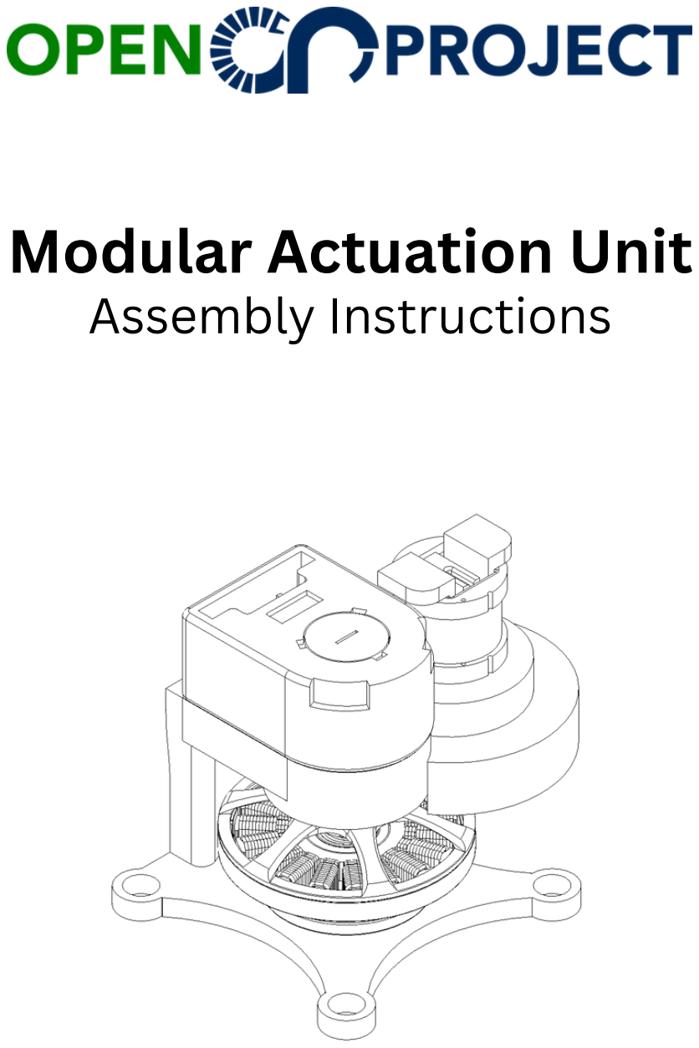
[picture p61: page 1]

# Assembly Instructions

# Exploded View

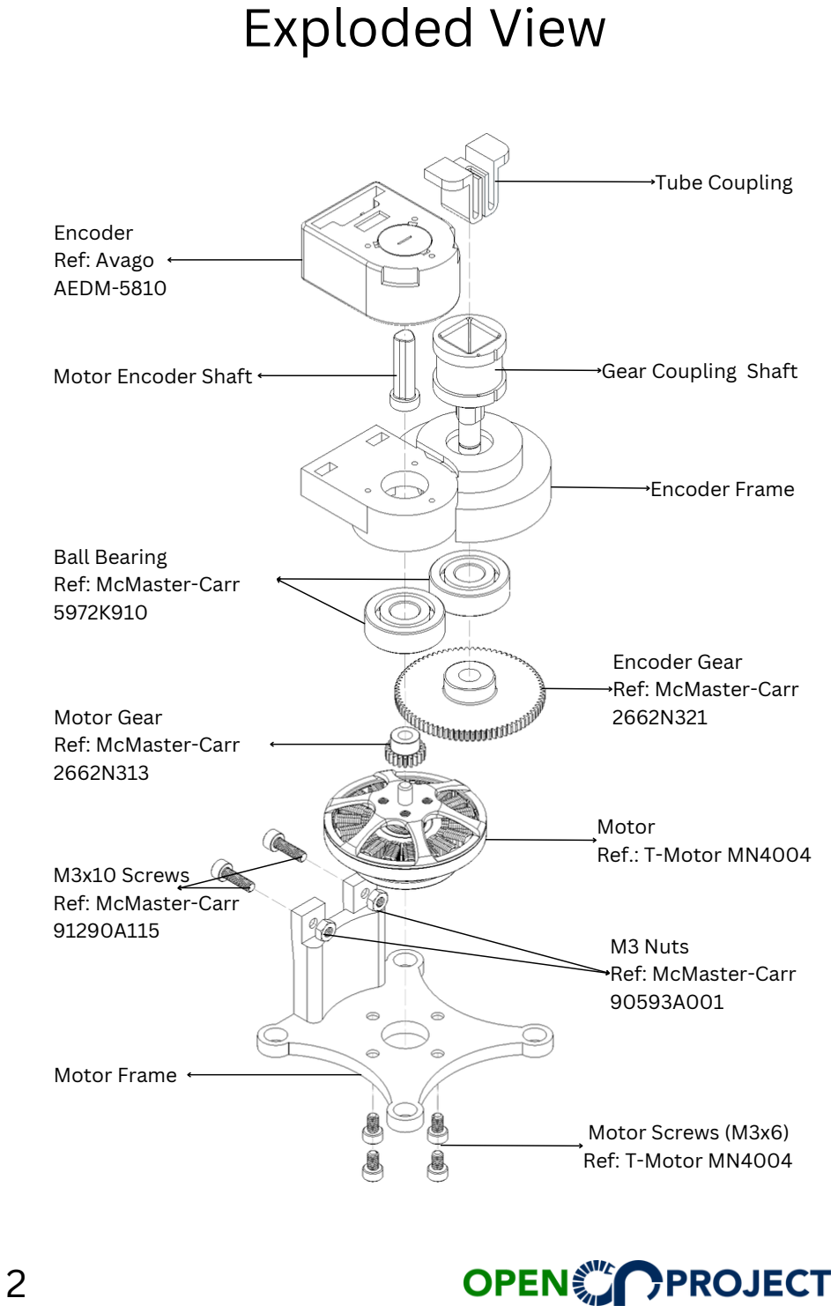
[picture p62: page 2]

Encoder
Ref: Avago
AEDM-5810

M3x10 Screws
Ref: McMaster-Carr
91290A115

Tube Coupling

Gear Coupling Shaft

Encoder Frame

Ball Bearing
Ref: McMaster-Carr
5972K910

Encoder Gear
Ref: McMaster-Carr
2662N321

Motor
Ref.: T-Motor MN4004

M3 Nuts
Ref: McMaster-Carr
90593A001

Motor Screws (M3x6)
Ref: T-Motor MN4004

Motor Encoder Shaft

Motor Gear
Ref: McMaster-Carr
2662N313

Motor Frame

# 3D Printed Parts

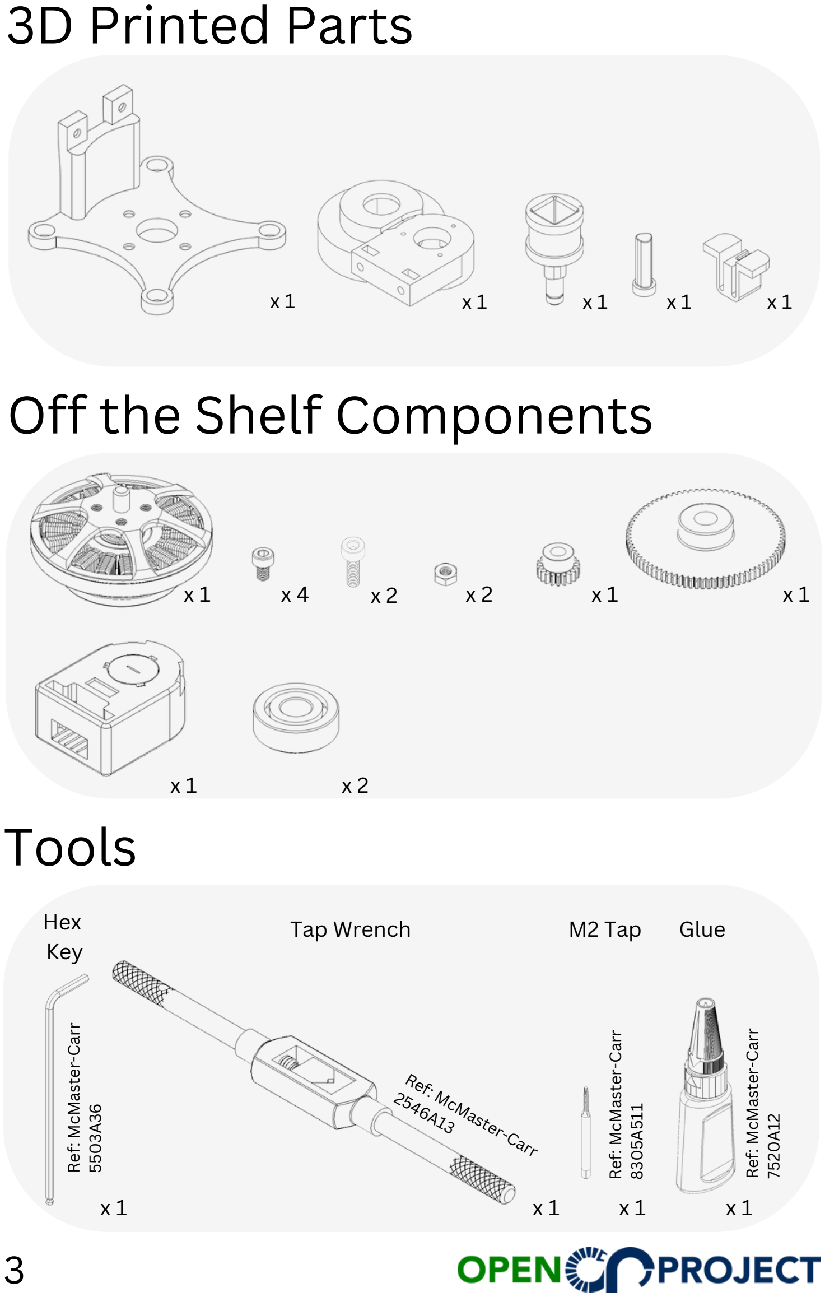
[picture p63: page 3]

x 1

# Off the Shelf Components

x 1 | x 1 | x 1 | x 1 | x 1
x 1 | x 4 | x 2 | x 2 | x 1 | x 1

x 2

x 1

x 1 | x 1 | x 1

Ref: McM

aster-C

arr

550

3

A

3

6
Ref: McM

aster-C

arr

7520

A12

Ref: McMaster-Carr
2546A13
Ref: McM

aster-C

arr

8

3

05A511

# Tools

Hex
Key
Tap Wrench | M2 Tap | Glue

# Supplementary Items

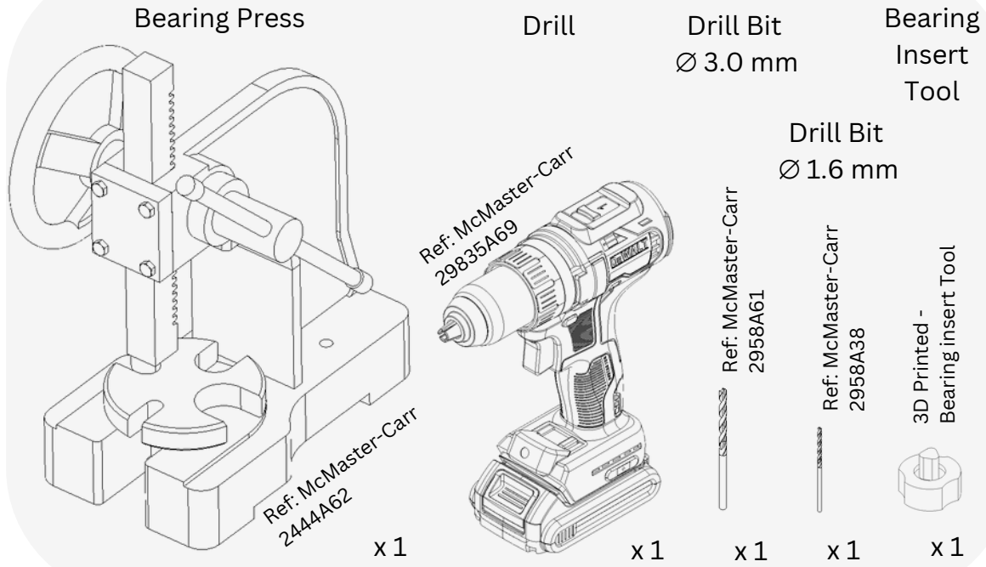
[picture p64: figure]
Ref: McMaster-Carr; Ref: McM; aster-C; arr; Printed -; Bearing insert T; Bearing Insert Tool; Bearing Press; Drill; Drill Bit; Drill Bit ⌀ 1.6 mm

# Step 1

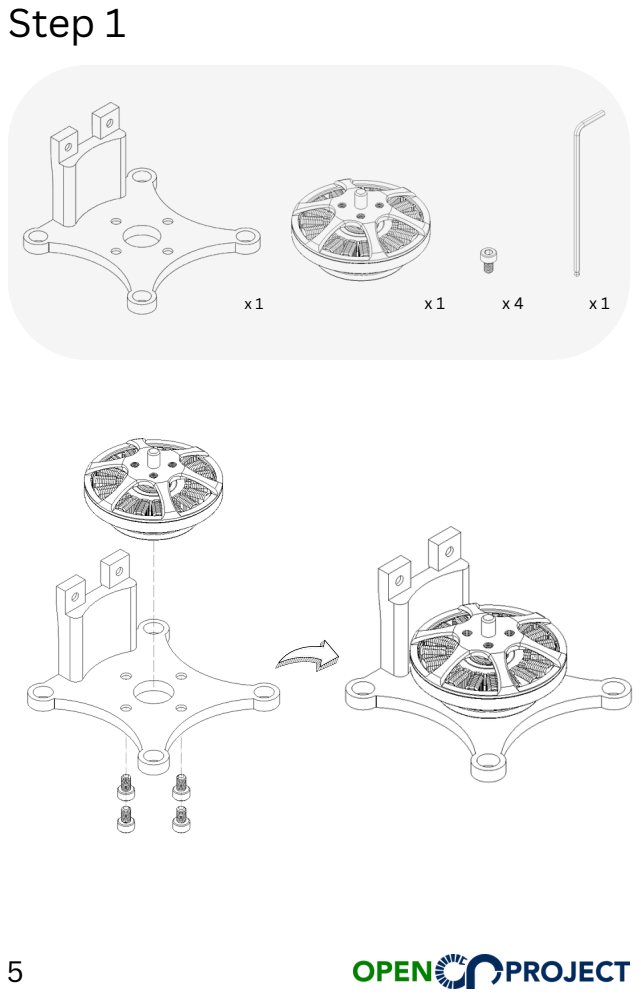
[picture p65: page 5]

# Step 2

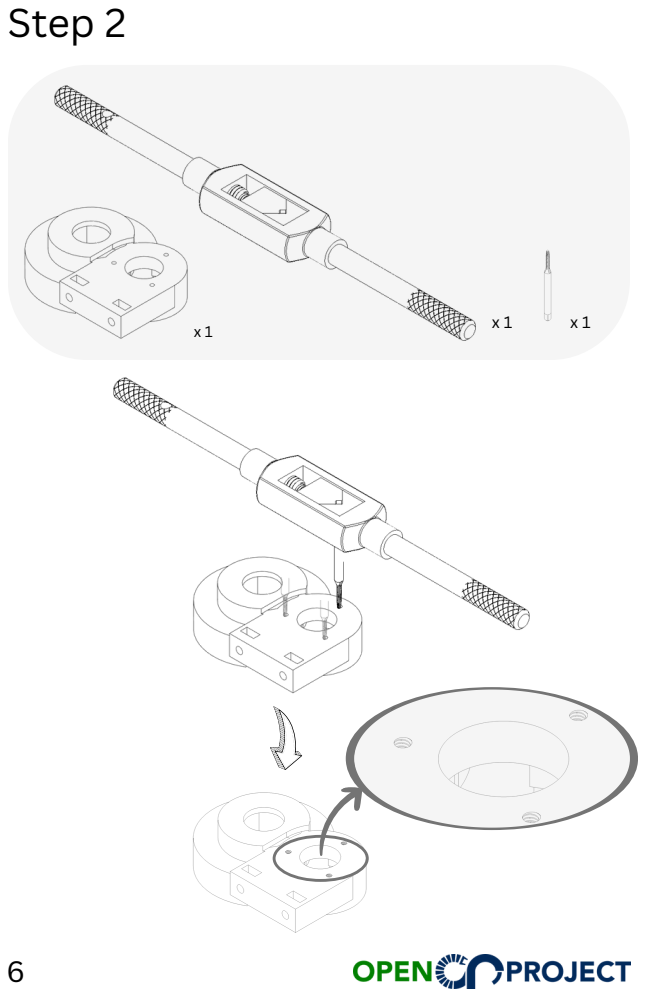
[picture p66: page 6]

# Step 3

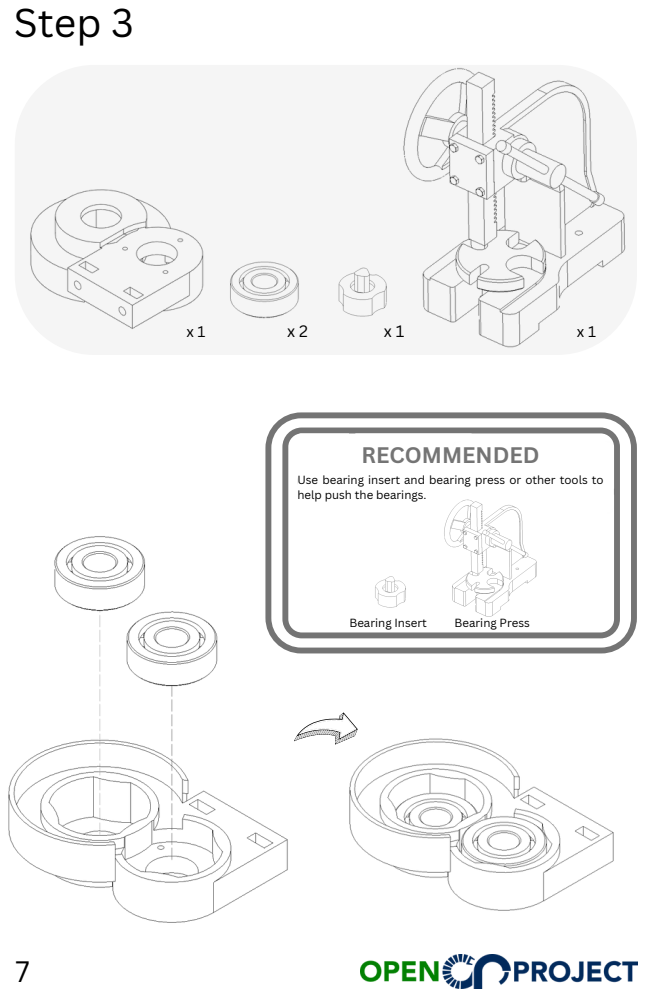
[picture p67: page 7]
RECOMMENDED; Bearing Insert; Bearing Press

Use bearing insert and bearing press or other tools to
help push the bearings.

# Step 4

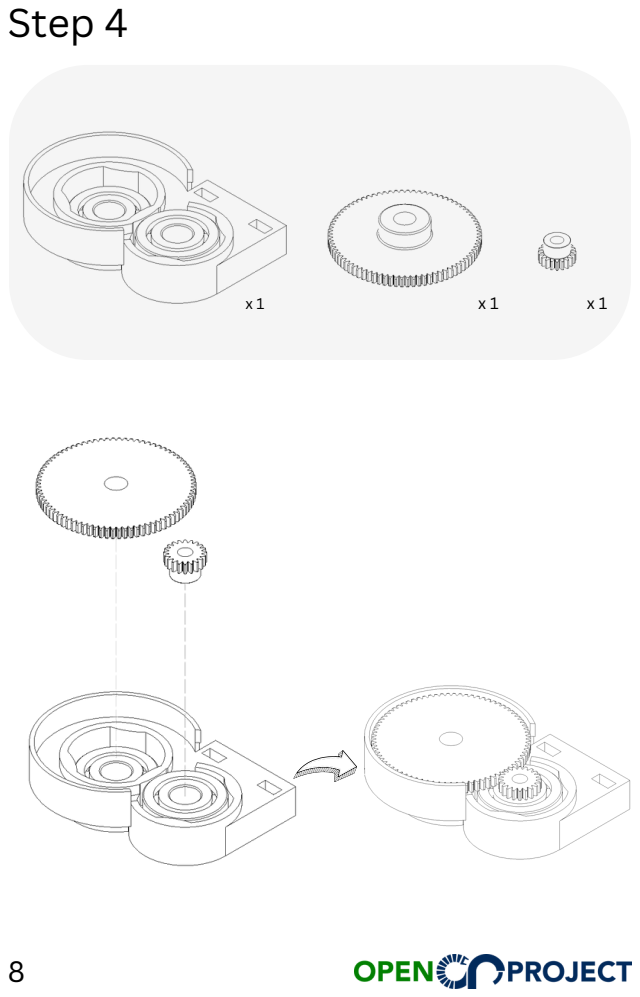
[picture p68: page 8]

# Step 5

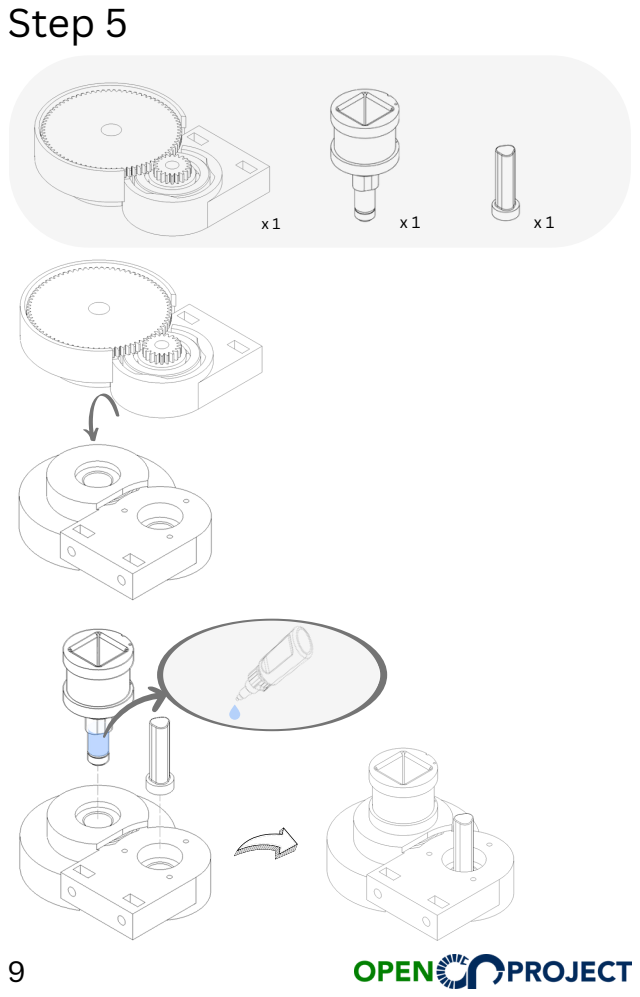
[picture p69: page 9]

# Step 6

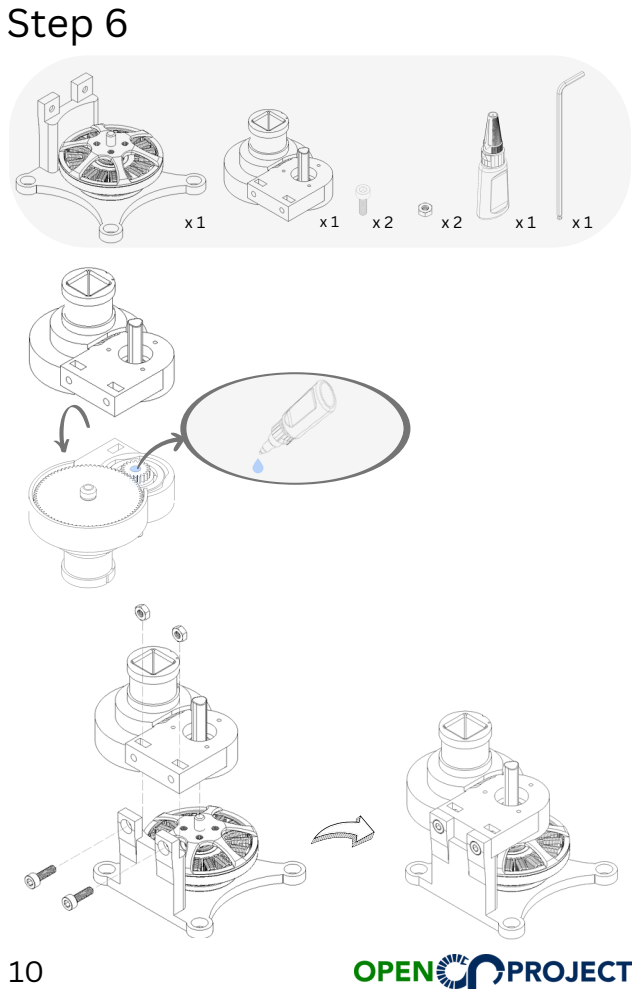
[picture p70: page 10]

# Step 7

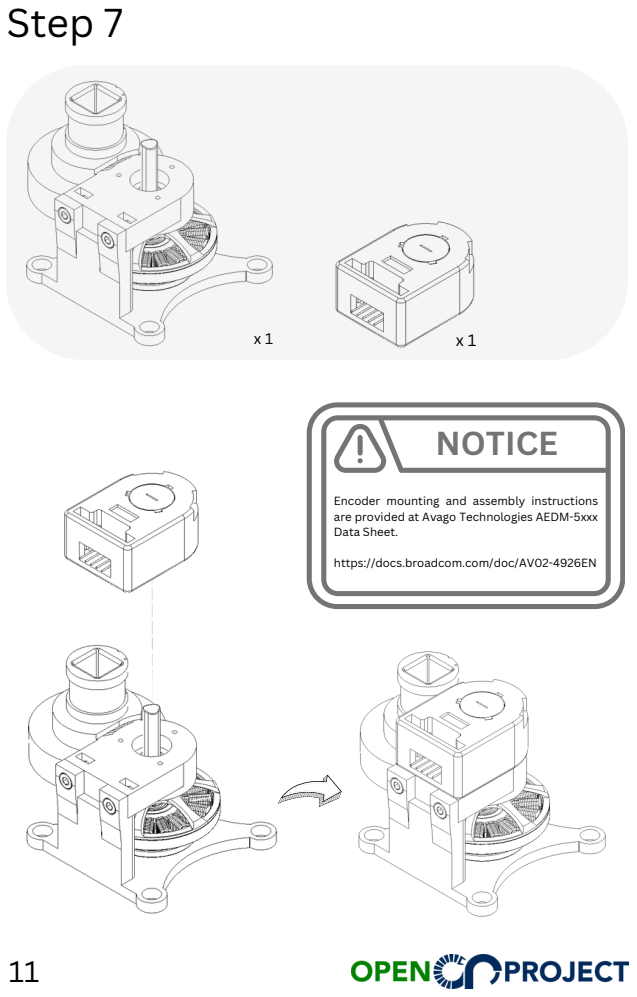
[picture p71: page 11]
NOTICE

Encoder mounting and assembly instructions
are provided at Avago Technologies AEDM-5xxx
Data Sheet.

https://docs.broadcom.com/doc/AV02-4926EN

# Step 8 - Optional

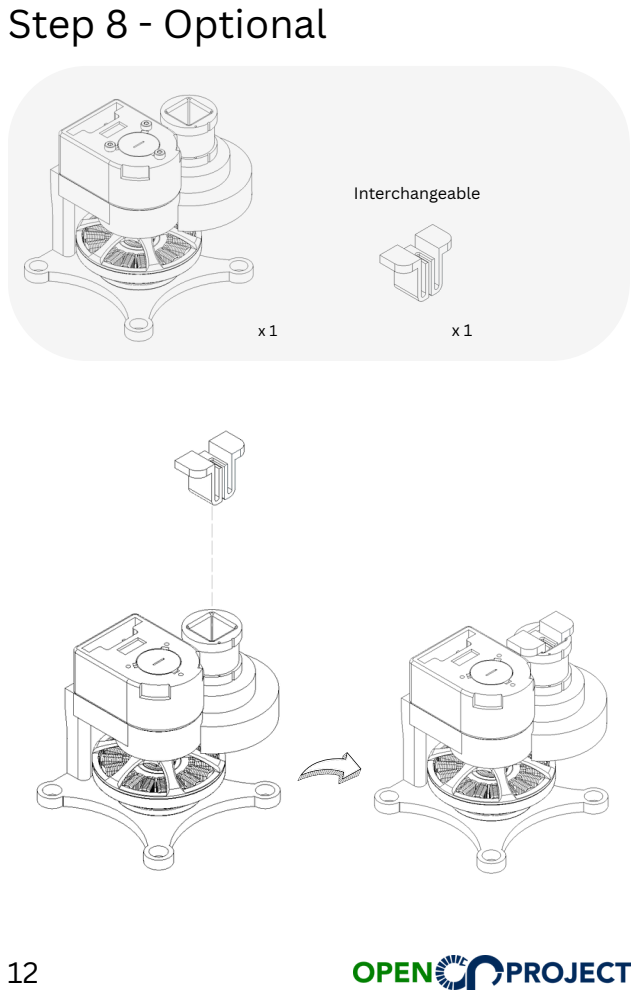
[picture p72: page 12]
Interchangeable
