CodeCraftsman-Jr/AgroWings/Materials/OpenCR-Hardware-main/OpenCR-Hardware-main/electronics/docs/images/electronics_board1.png

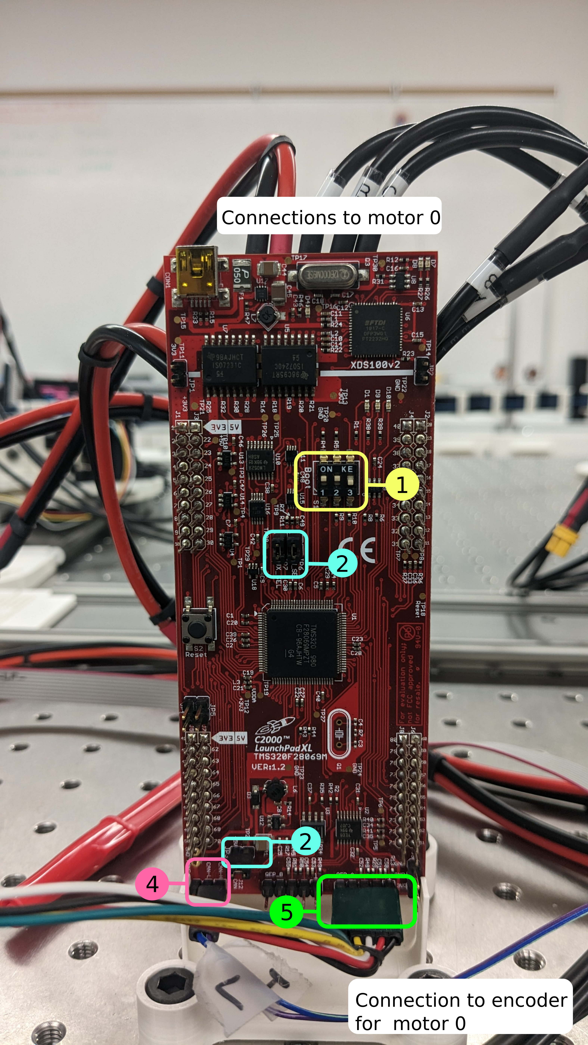
[picture p60: Materials/OpenCR-Hardware-main/OpenCR-Hardware-main/electronics/docs/images/electronics_board1.png]
Materials/OpenCR-Hardware-main/OpenCR-Hardware-main/electronics/docs/images/electronics_board1.png
